NaoPross/z80uPC/doc/report/res/logo_sam.pdf

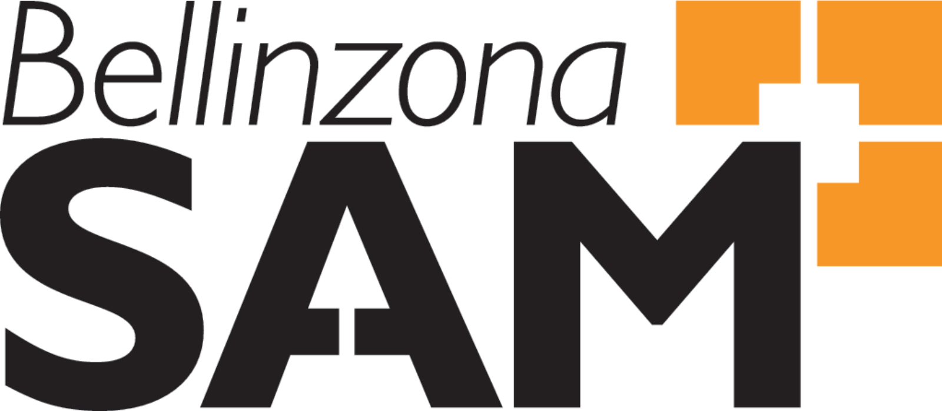
[picture p2: page 1]
