NaoPross/z80uPC/res/ATFBlast_ALL/ATFblast.TIF

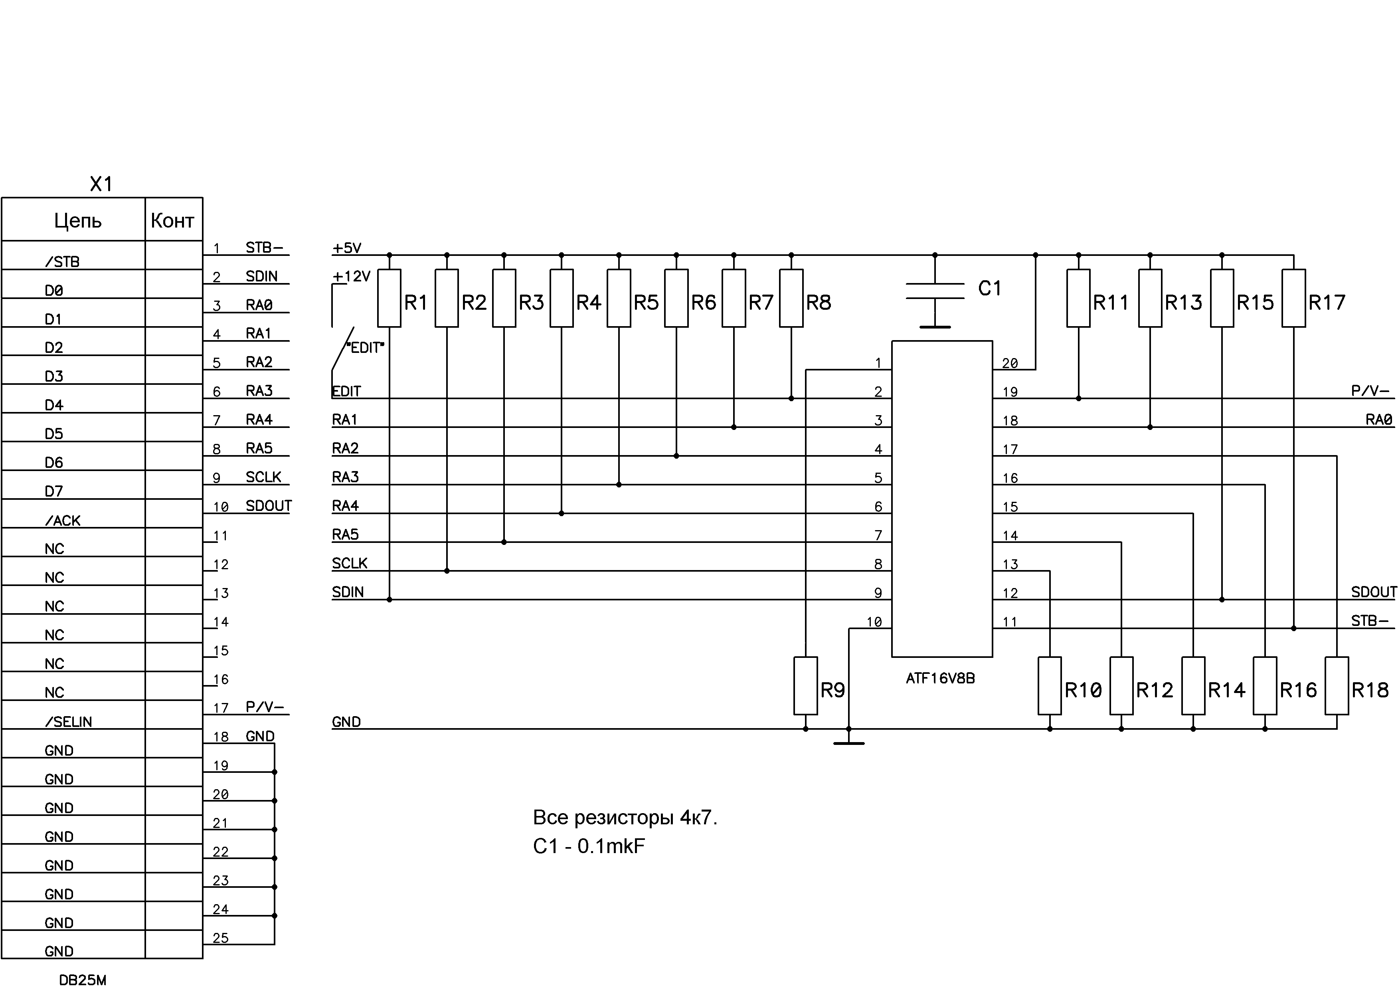
res/ATFBlast_ALL/ATFblast.TIF
