NaoPross/z80uPC/res/ATFBlast_ALL/direct.gif

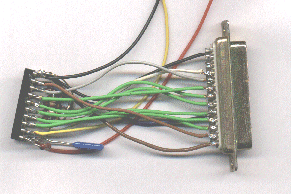
res/ATFBlast_ALL/direct.gif
