NaoPross/z80uPC/doc/BOM.ods

Z80 MicroComputer BOM
Tipo | Componente | Specifica | Package | Prezzo | PCS | Fornitore | Link
Processore | Z8400AB1 | Z80ACPU | PLCC-68 |  | 1 | SAM
Porta I/O | Z8420AB1 | Z80APIO | PDIP-40 |  | 1 | SAM
Timer | Z8430AB1 | Z80ACTC | PDIP-28
RAM | HM62256BPL-7 | 8K x 8bit | PDIP-28 |  | 2 | SAM
EEPROM | AT28C64B-15PU | 8K x 8bit | PDIP-28 |  | 2 | SAM
UART RS232 | TL16C550CFN |  | PLCC-44 | SFr. 4.35 | 1 | Distrelec | http://www.distrelec.ch/en/interface-ic-uart-plcc-44-tl16c550-texas-instruments-tl16c550cfn/p/30011774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
total |  |  |  | SFr. 4.35
