NaoPross/z80uPC/hw/Project Outputs for z80uPC/z80uPC.pdf

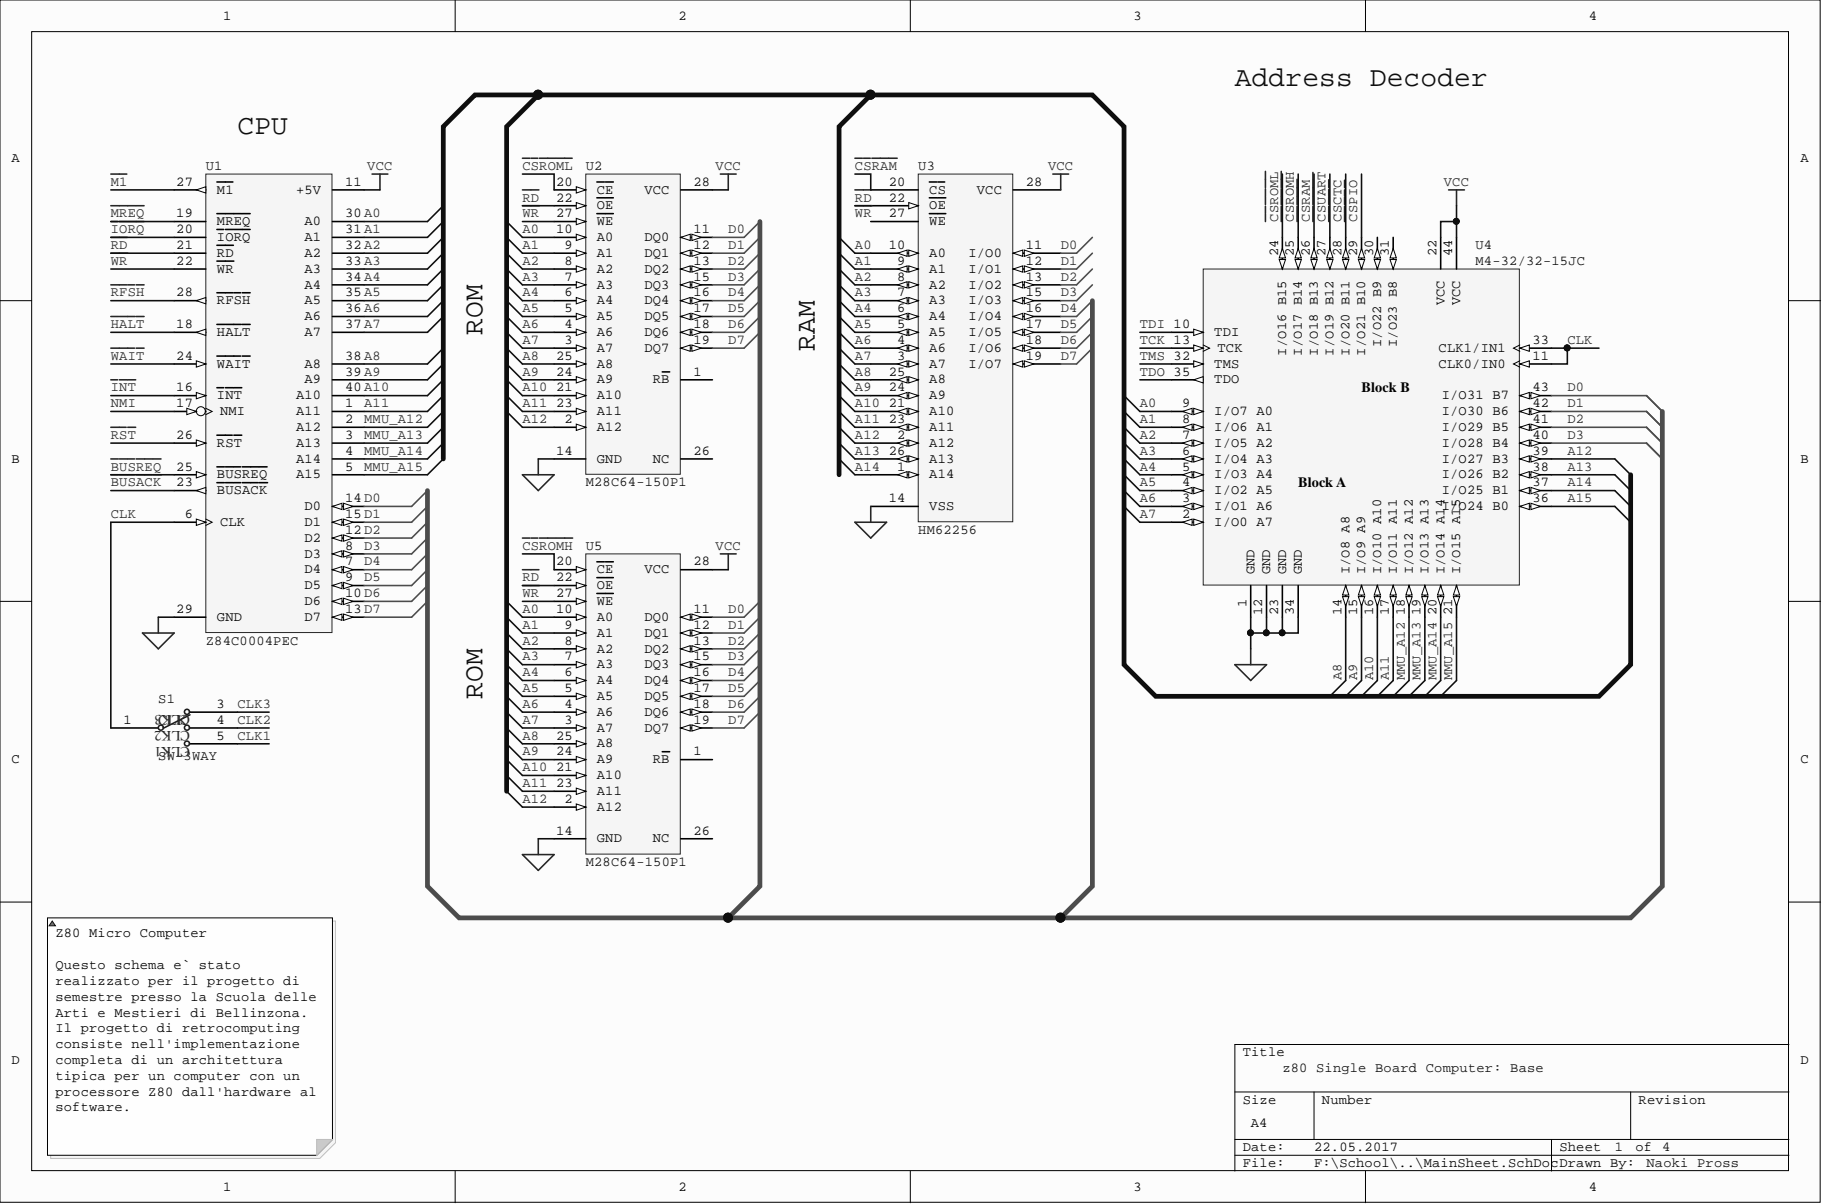
[picture p7: page 1]

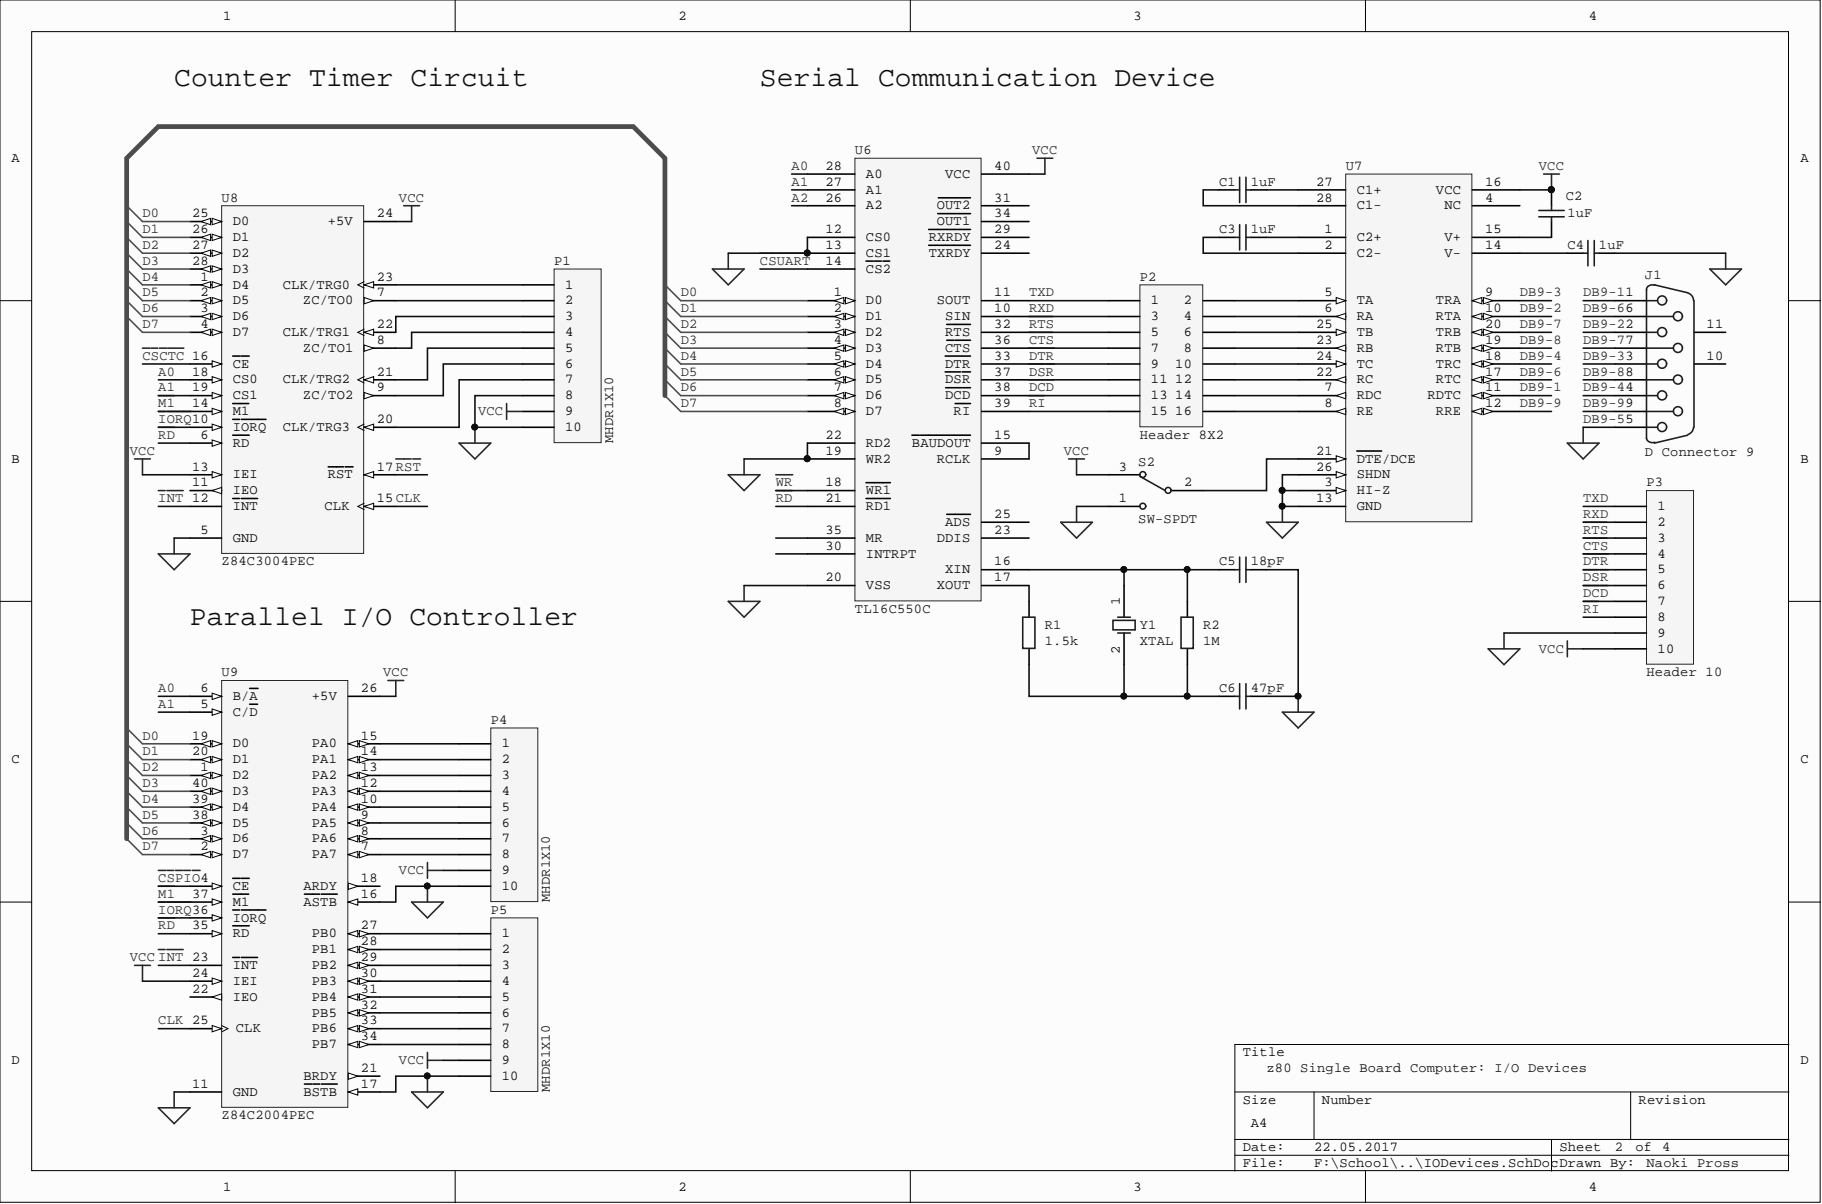
[picture p8: page 2]

1 0 R X D | 6 | 1 0 D B 9 -
3 2 R T S | 2 5 | 2 0 D B 9 -

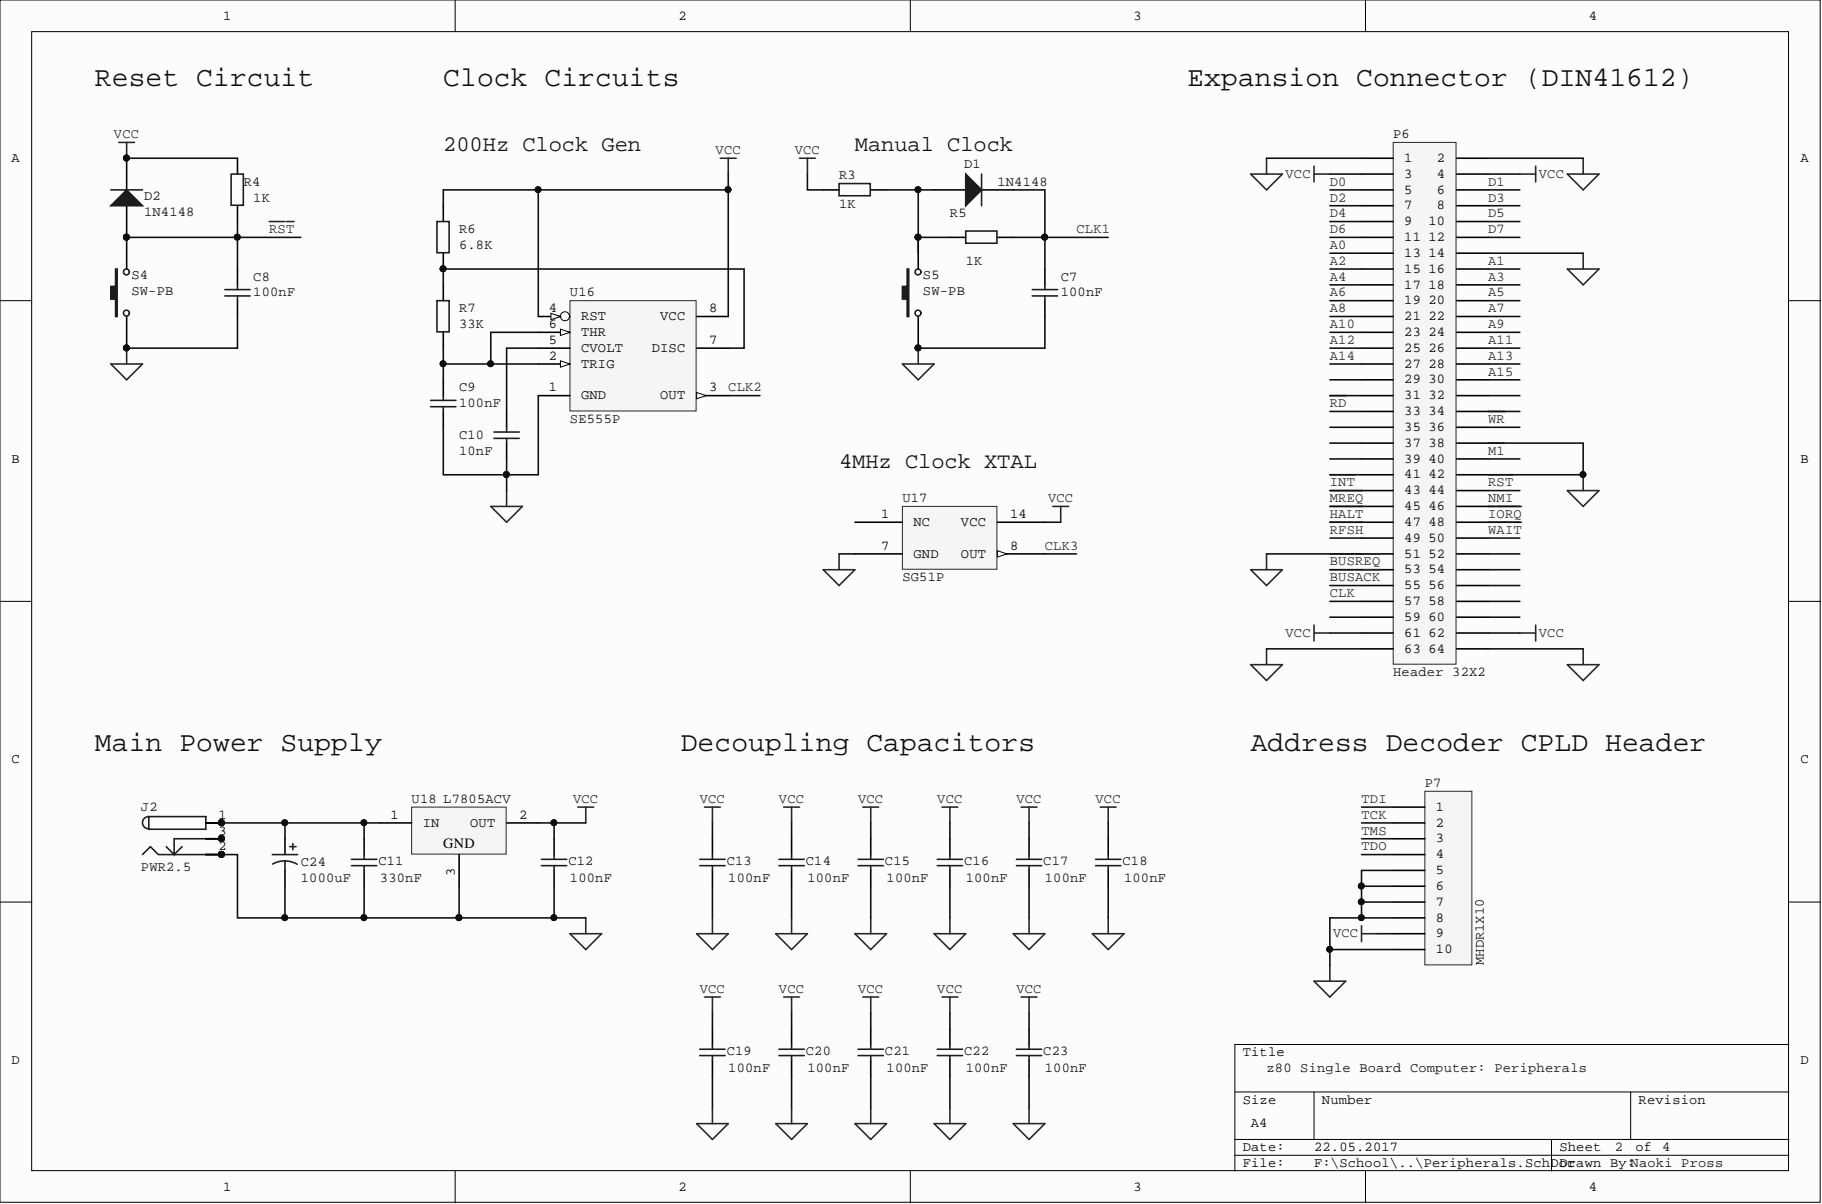
[picture p9: page 3]

TRIG 2

GND 1

Address Decoder CPLD Header

Title
z80 Single Board Computer: Peripherals

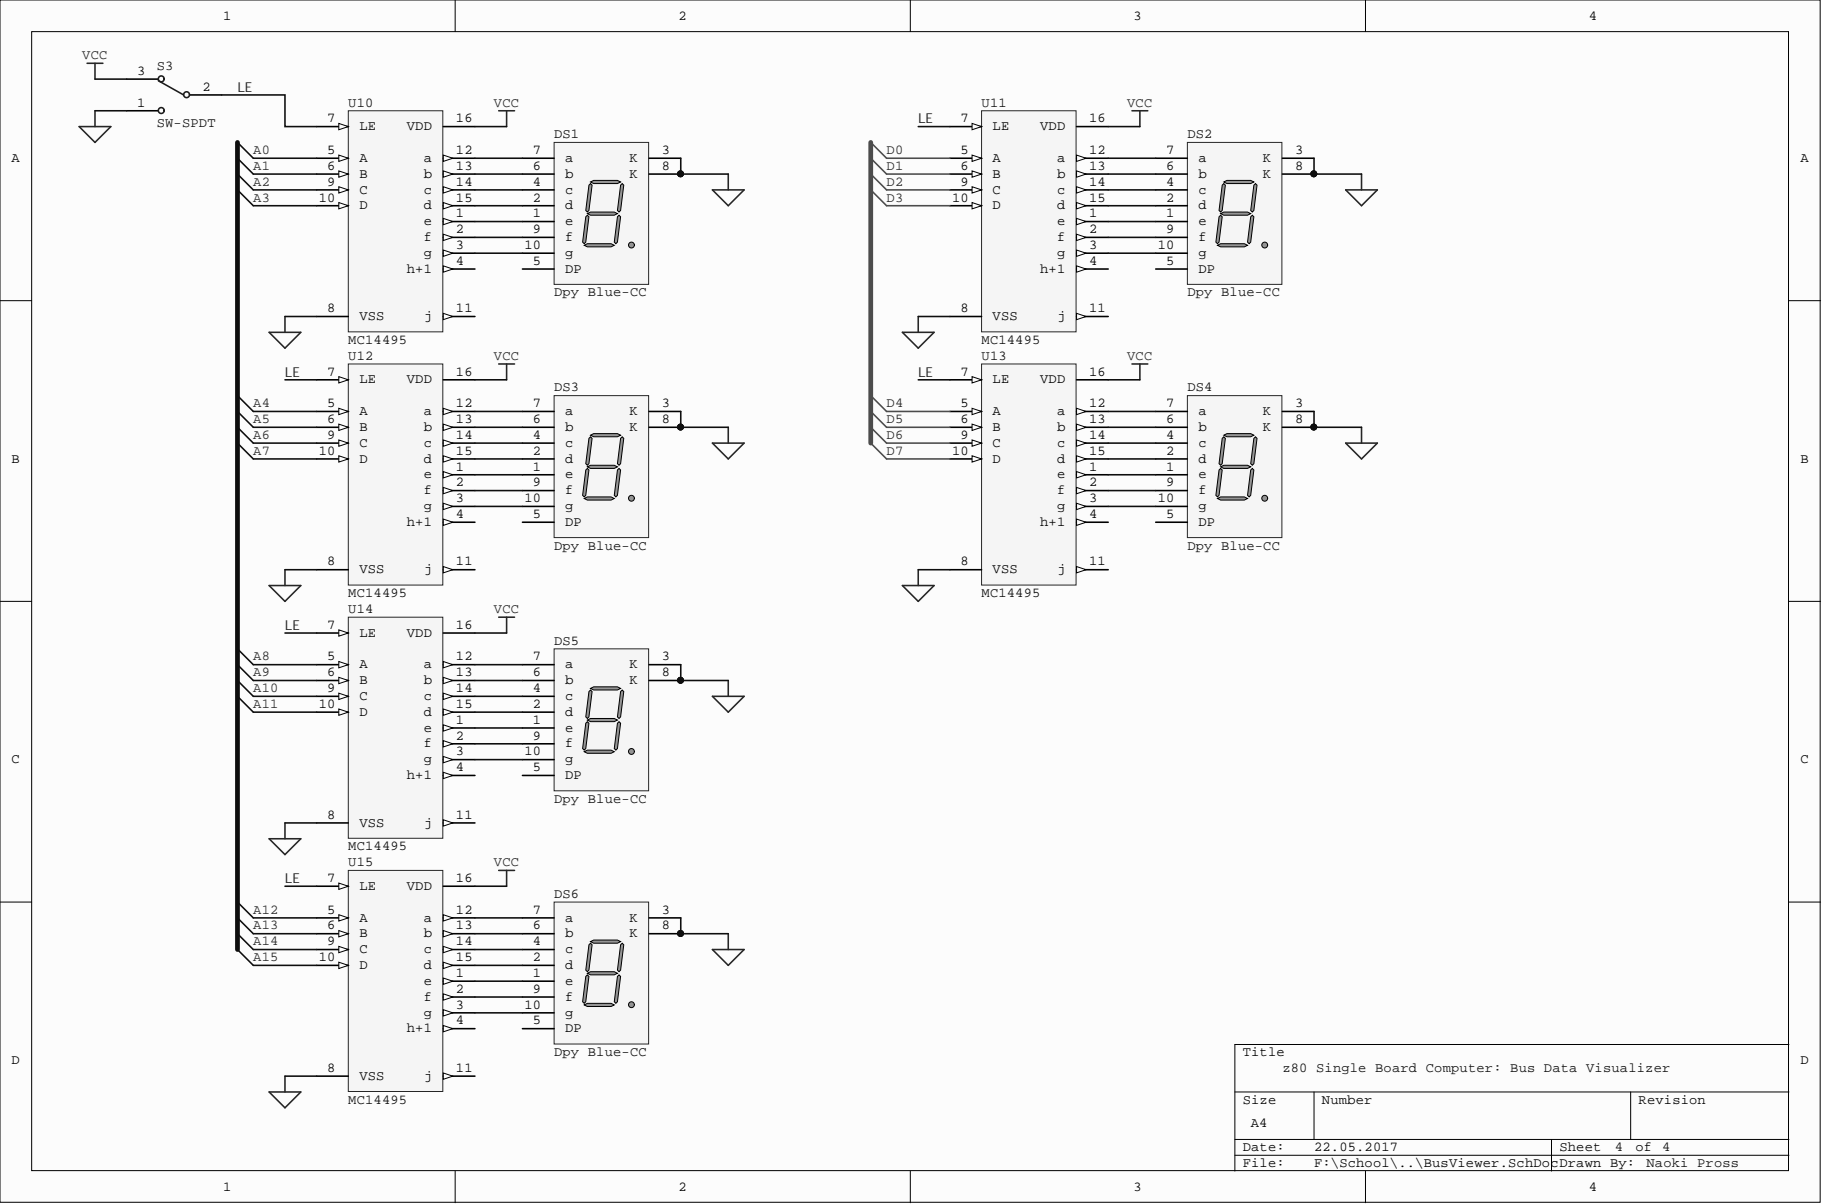
[picture p10: page 4]

z80 Single Board Computer: Bus Data Visualizer
