NaoPross/z80uPC/doc/report/res/block_diagram.pdf

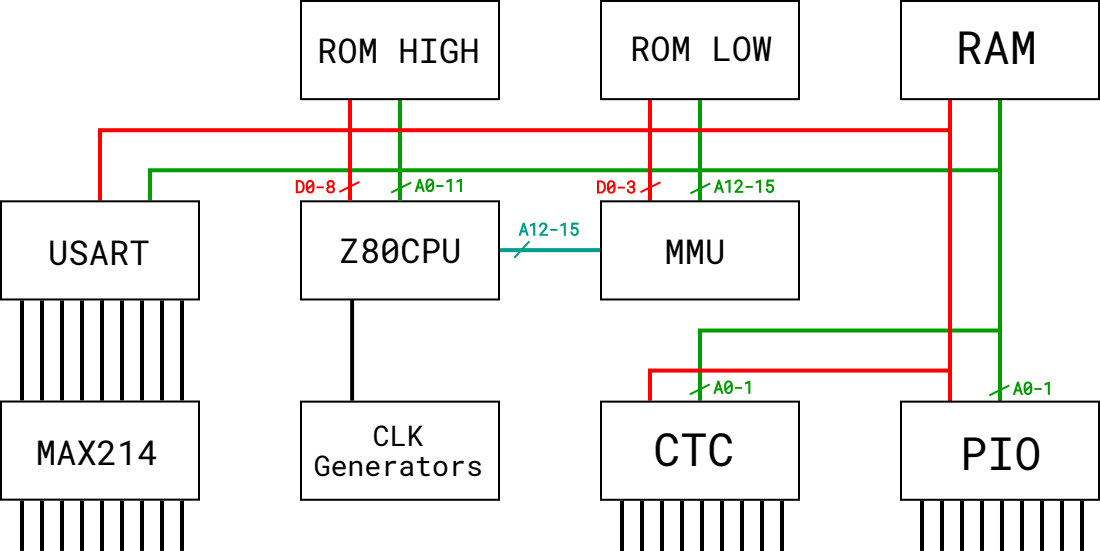
[picture p11: page 1]
Z80CPU; ROM HIGH; ROM LOW; RAM; MMU; CLK; Generators; CTC; PIO; USART; MAX214
