NaoPross/z80uPC/hw/Project Outputs for z80uPC/z80uPC_PCB.pdf

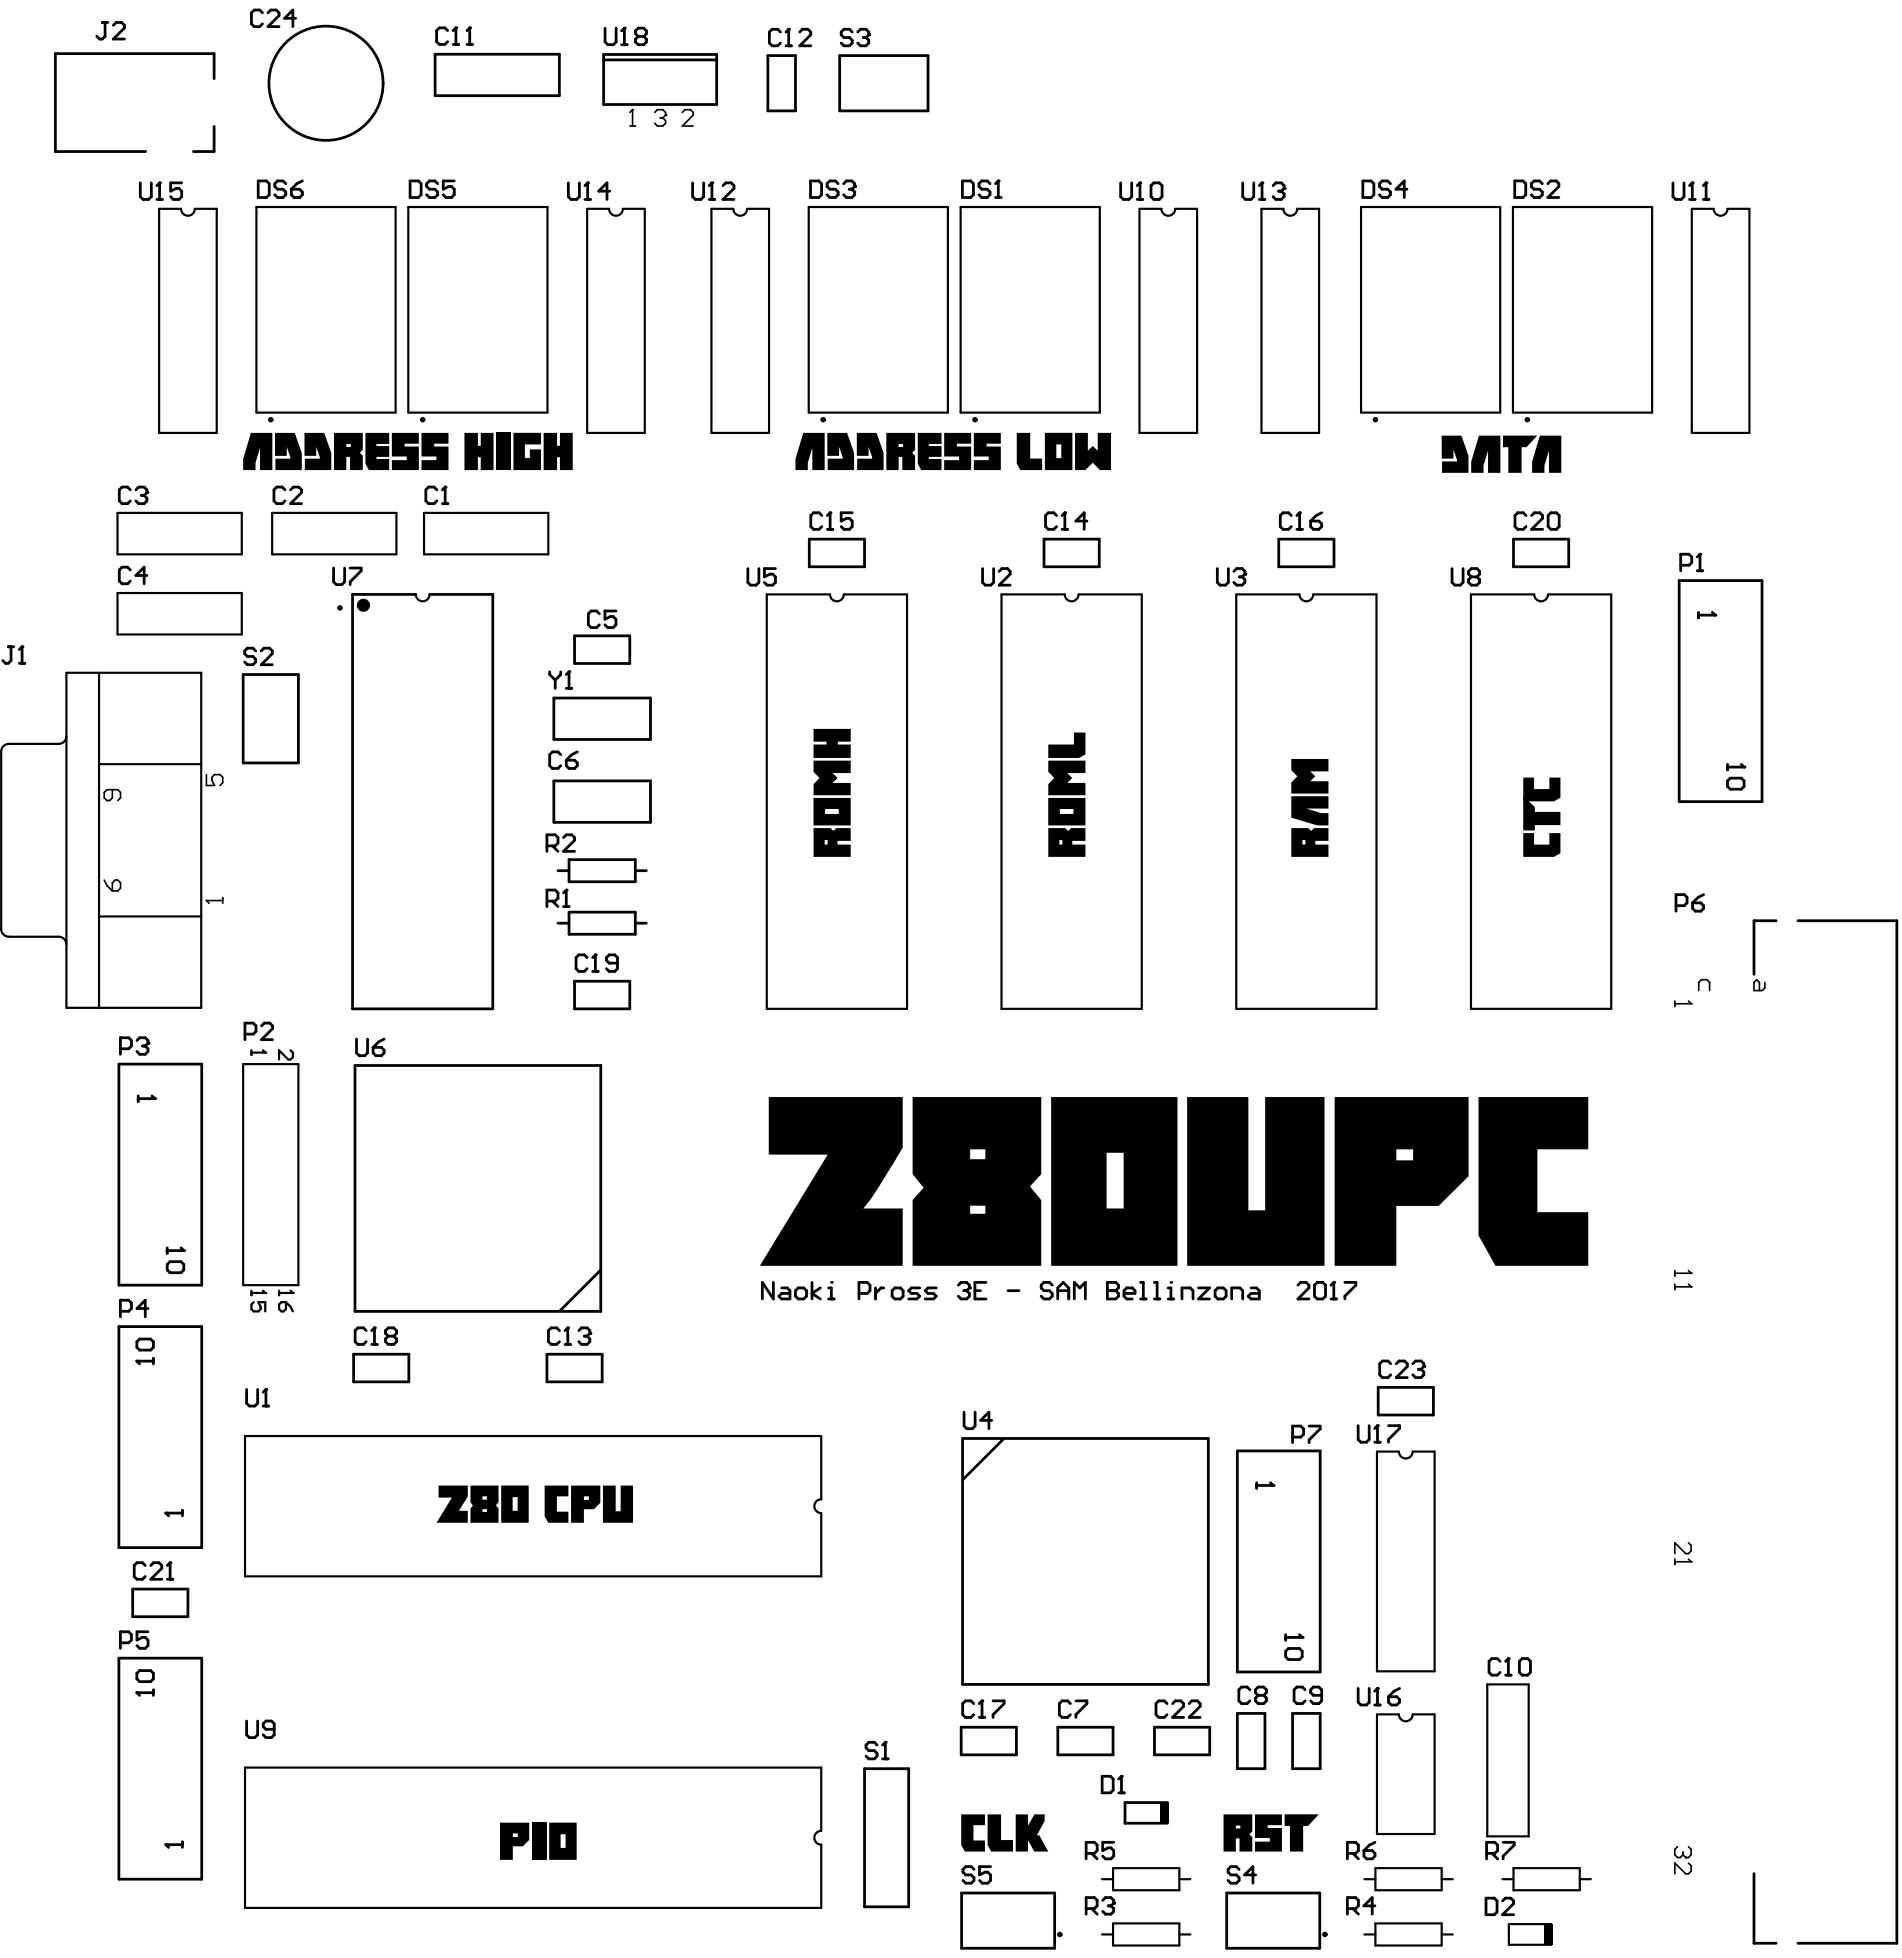
[picture p12: page 1]

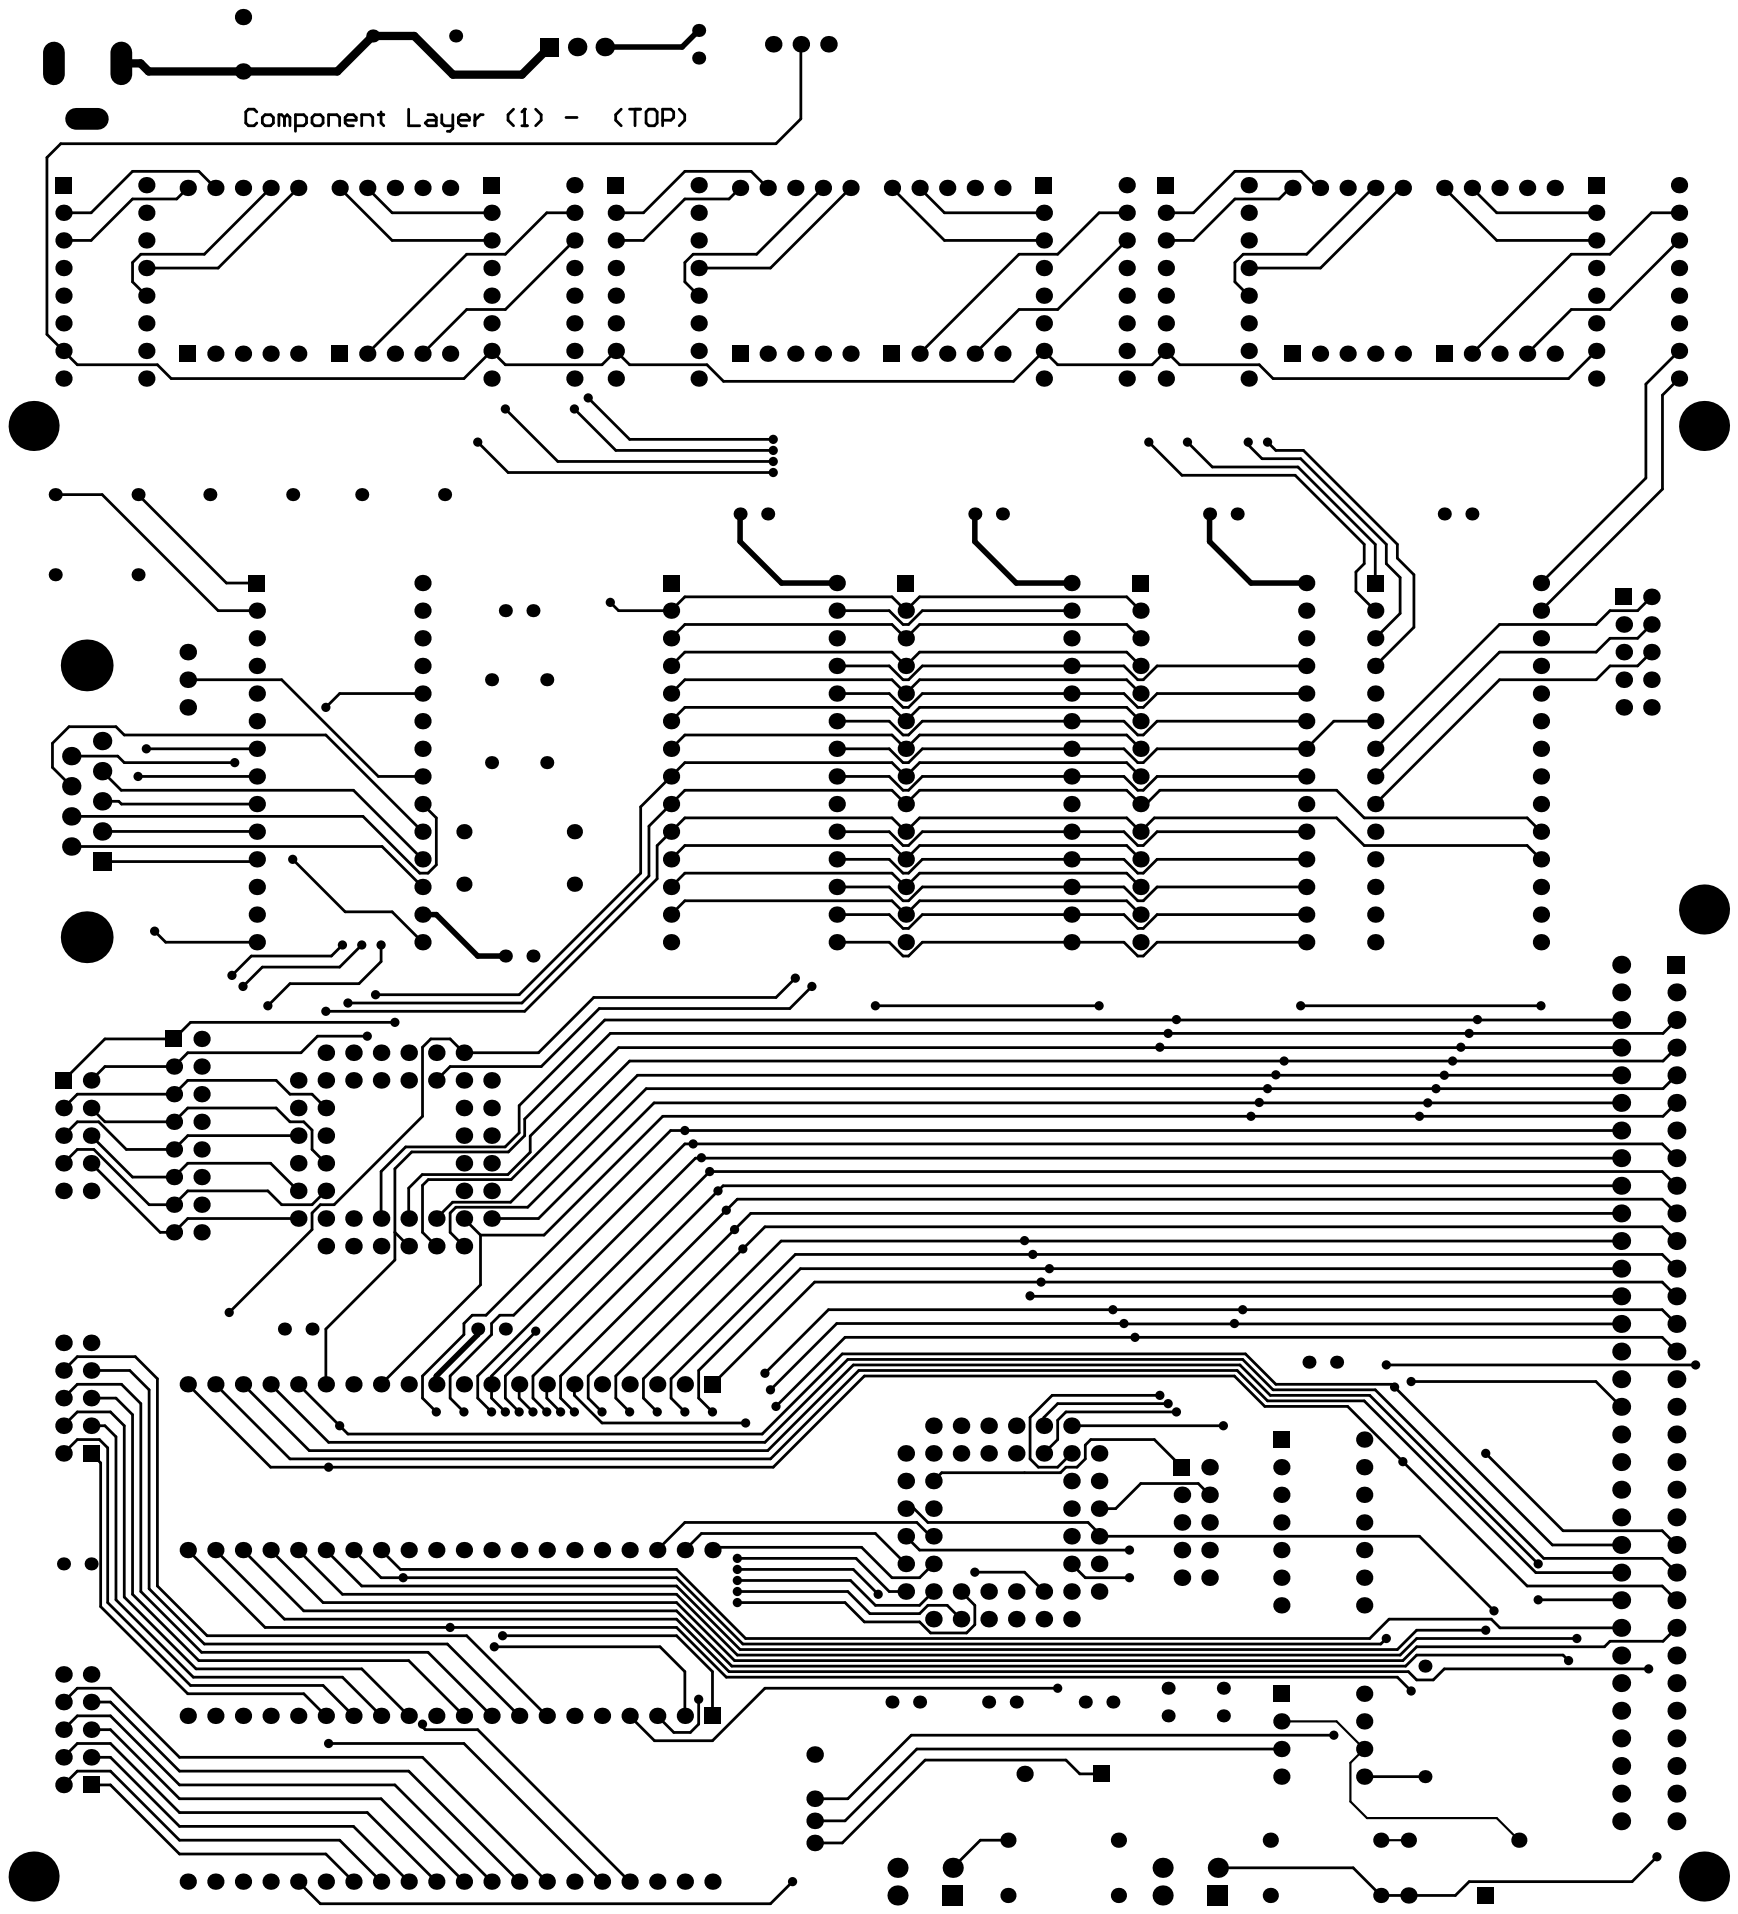
[picture p13: page 2]

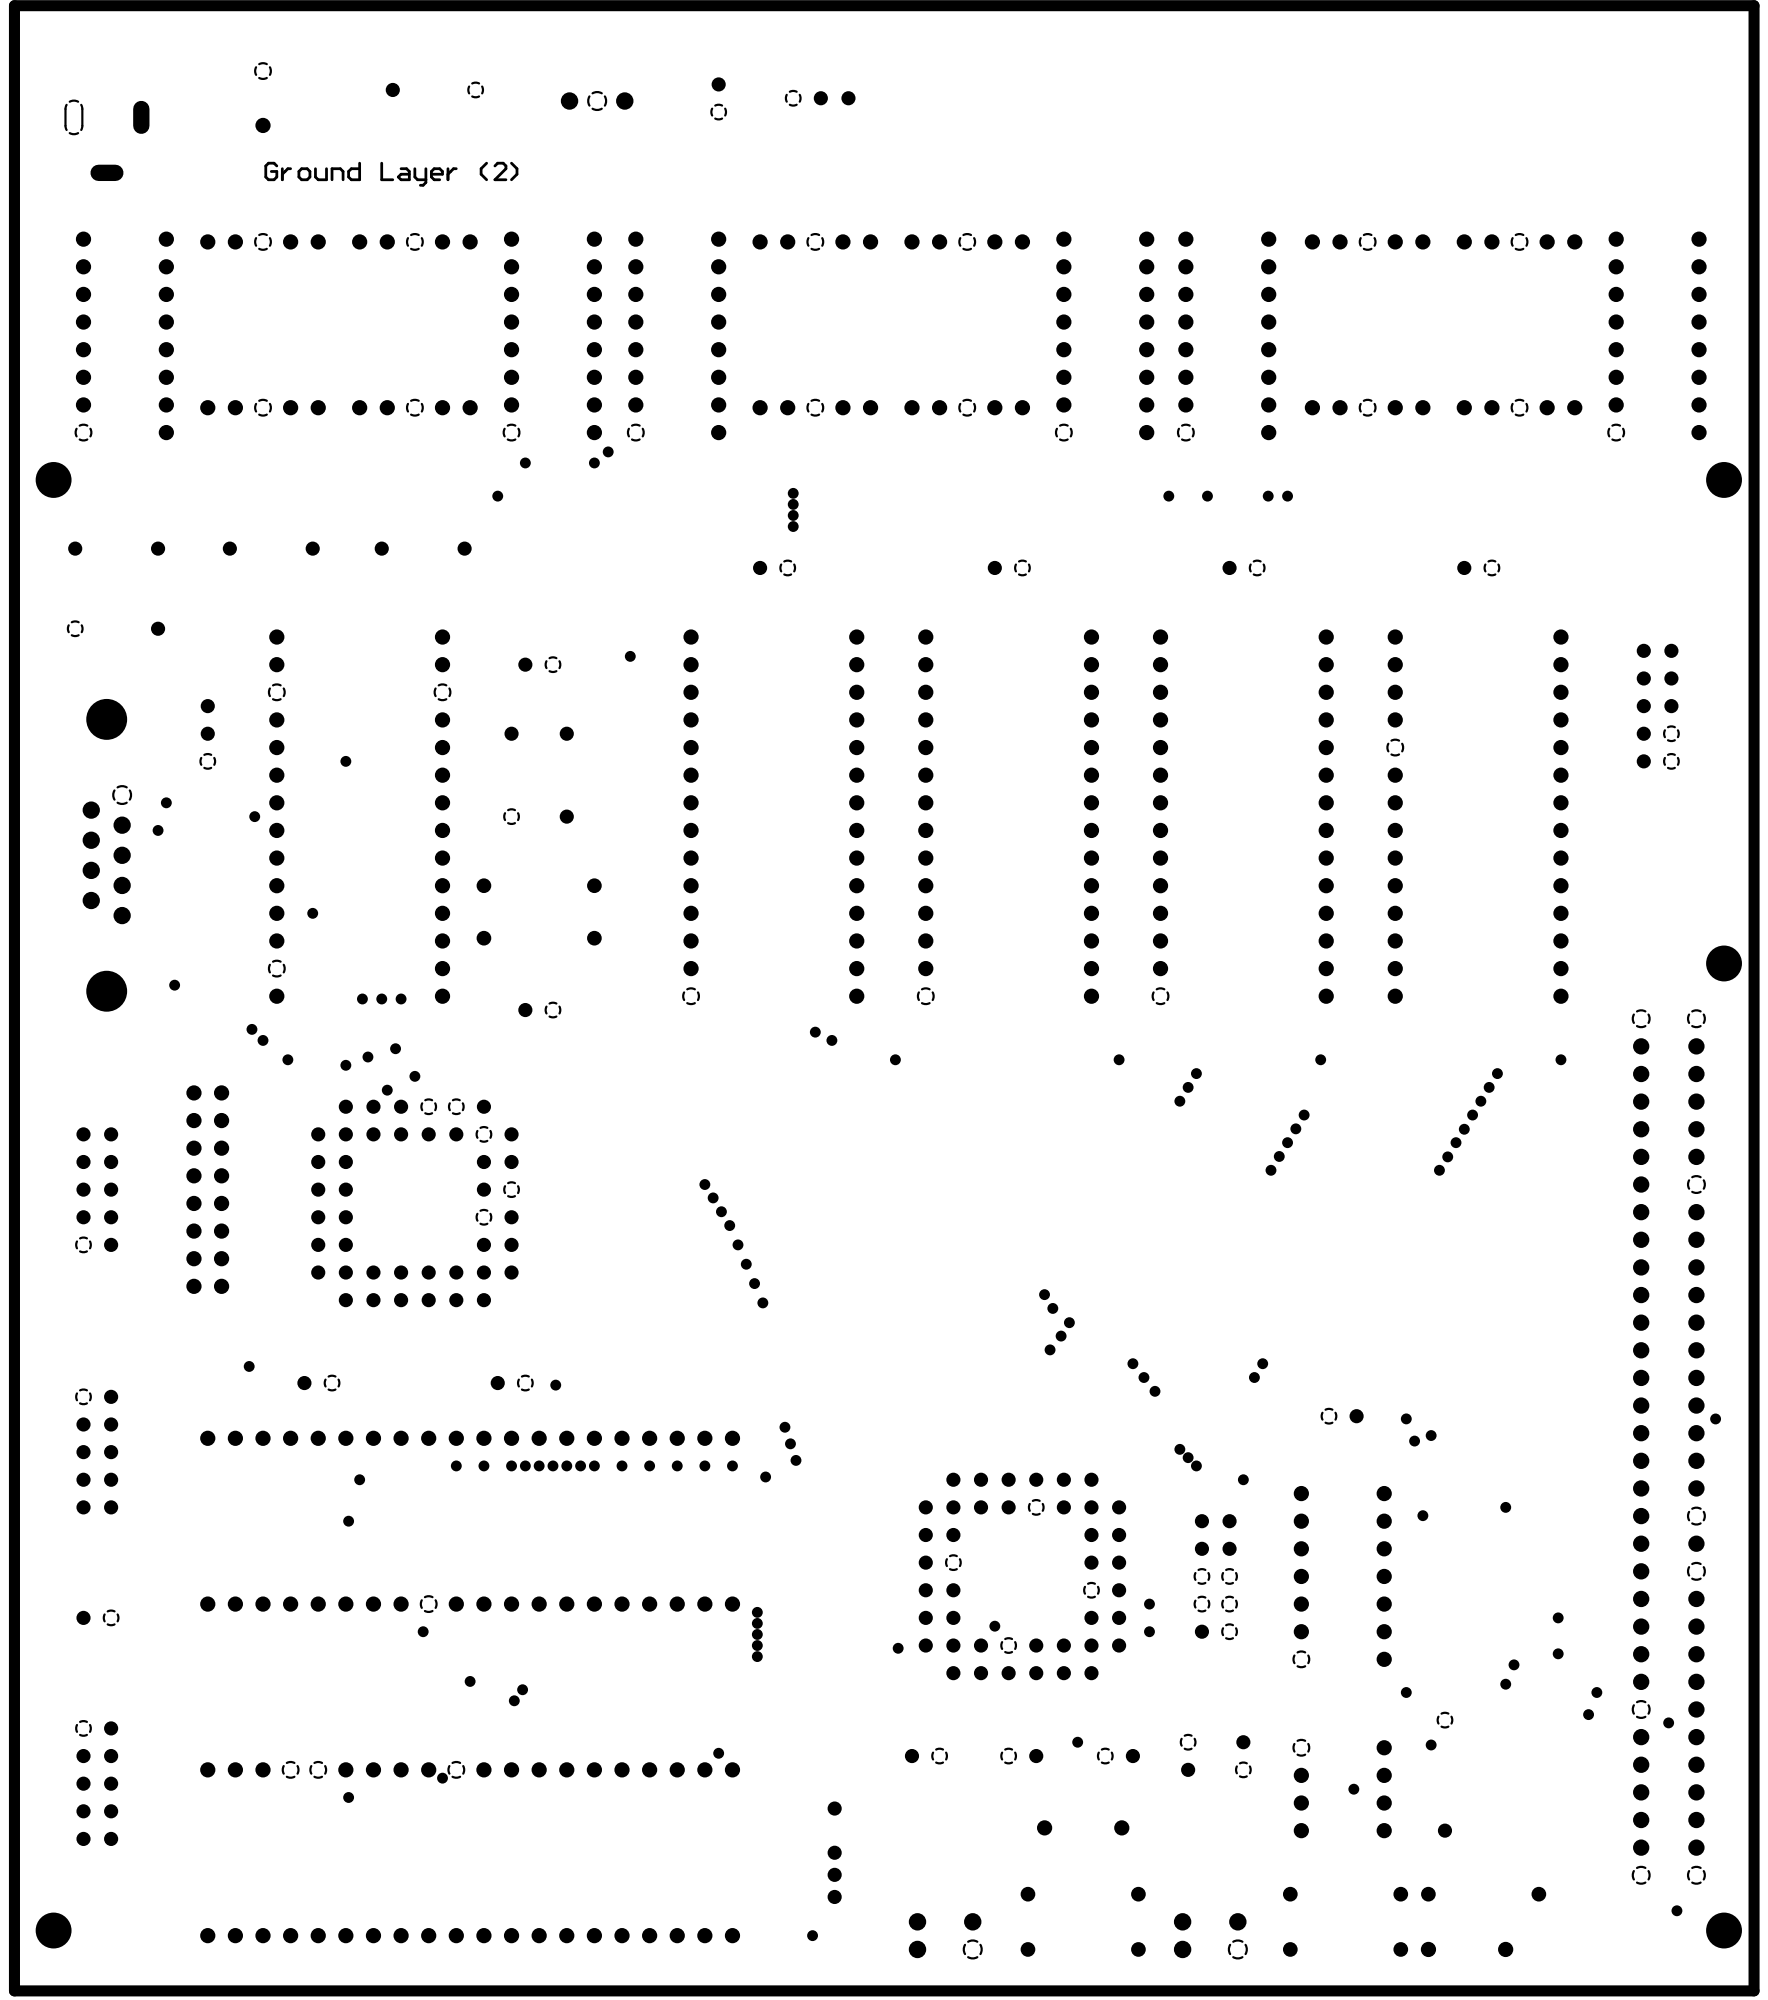
[picture p14: page 3]

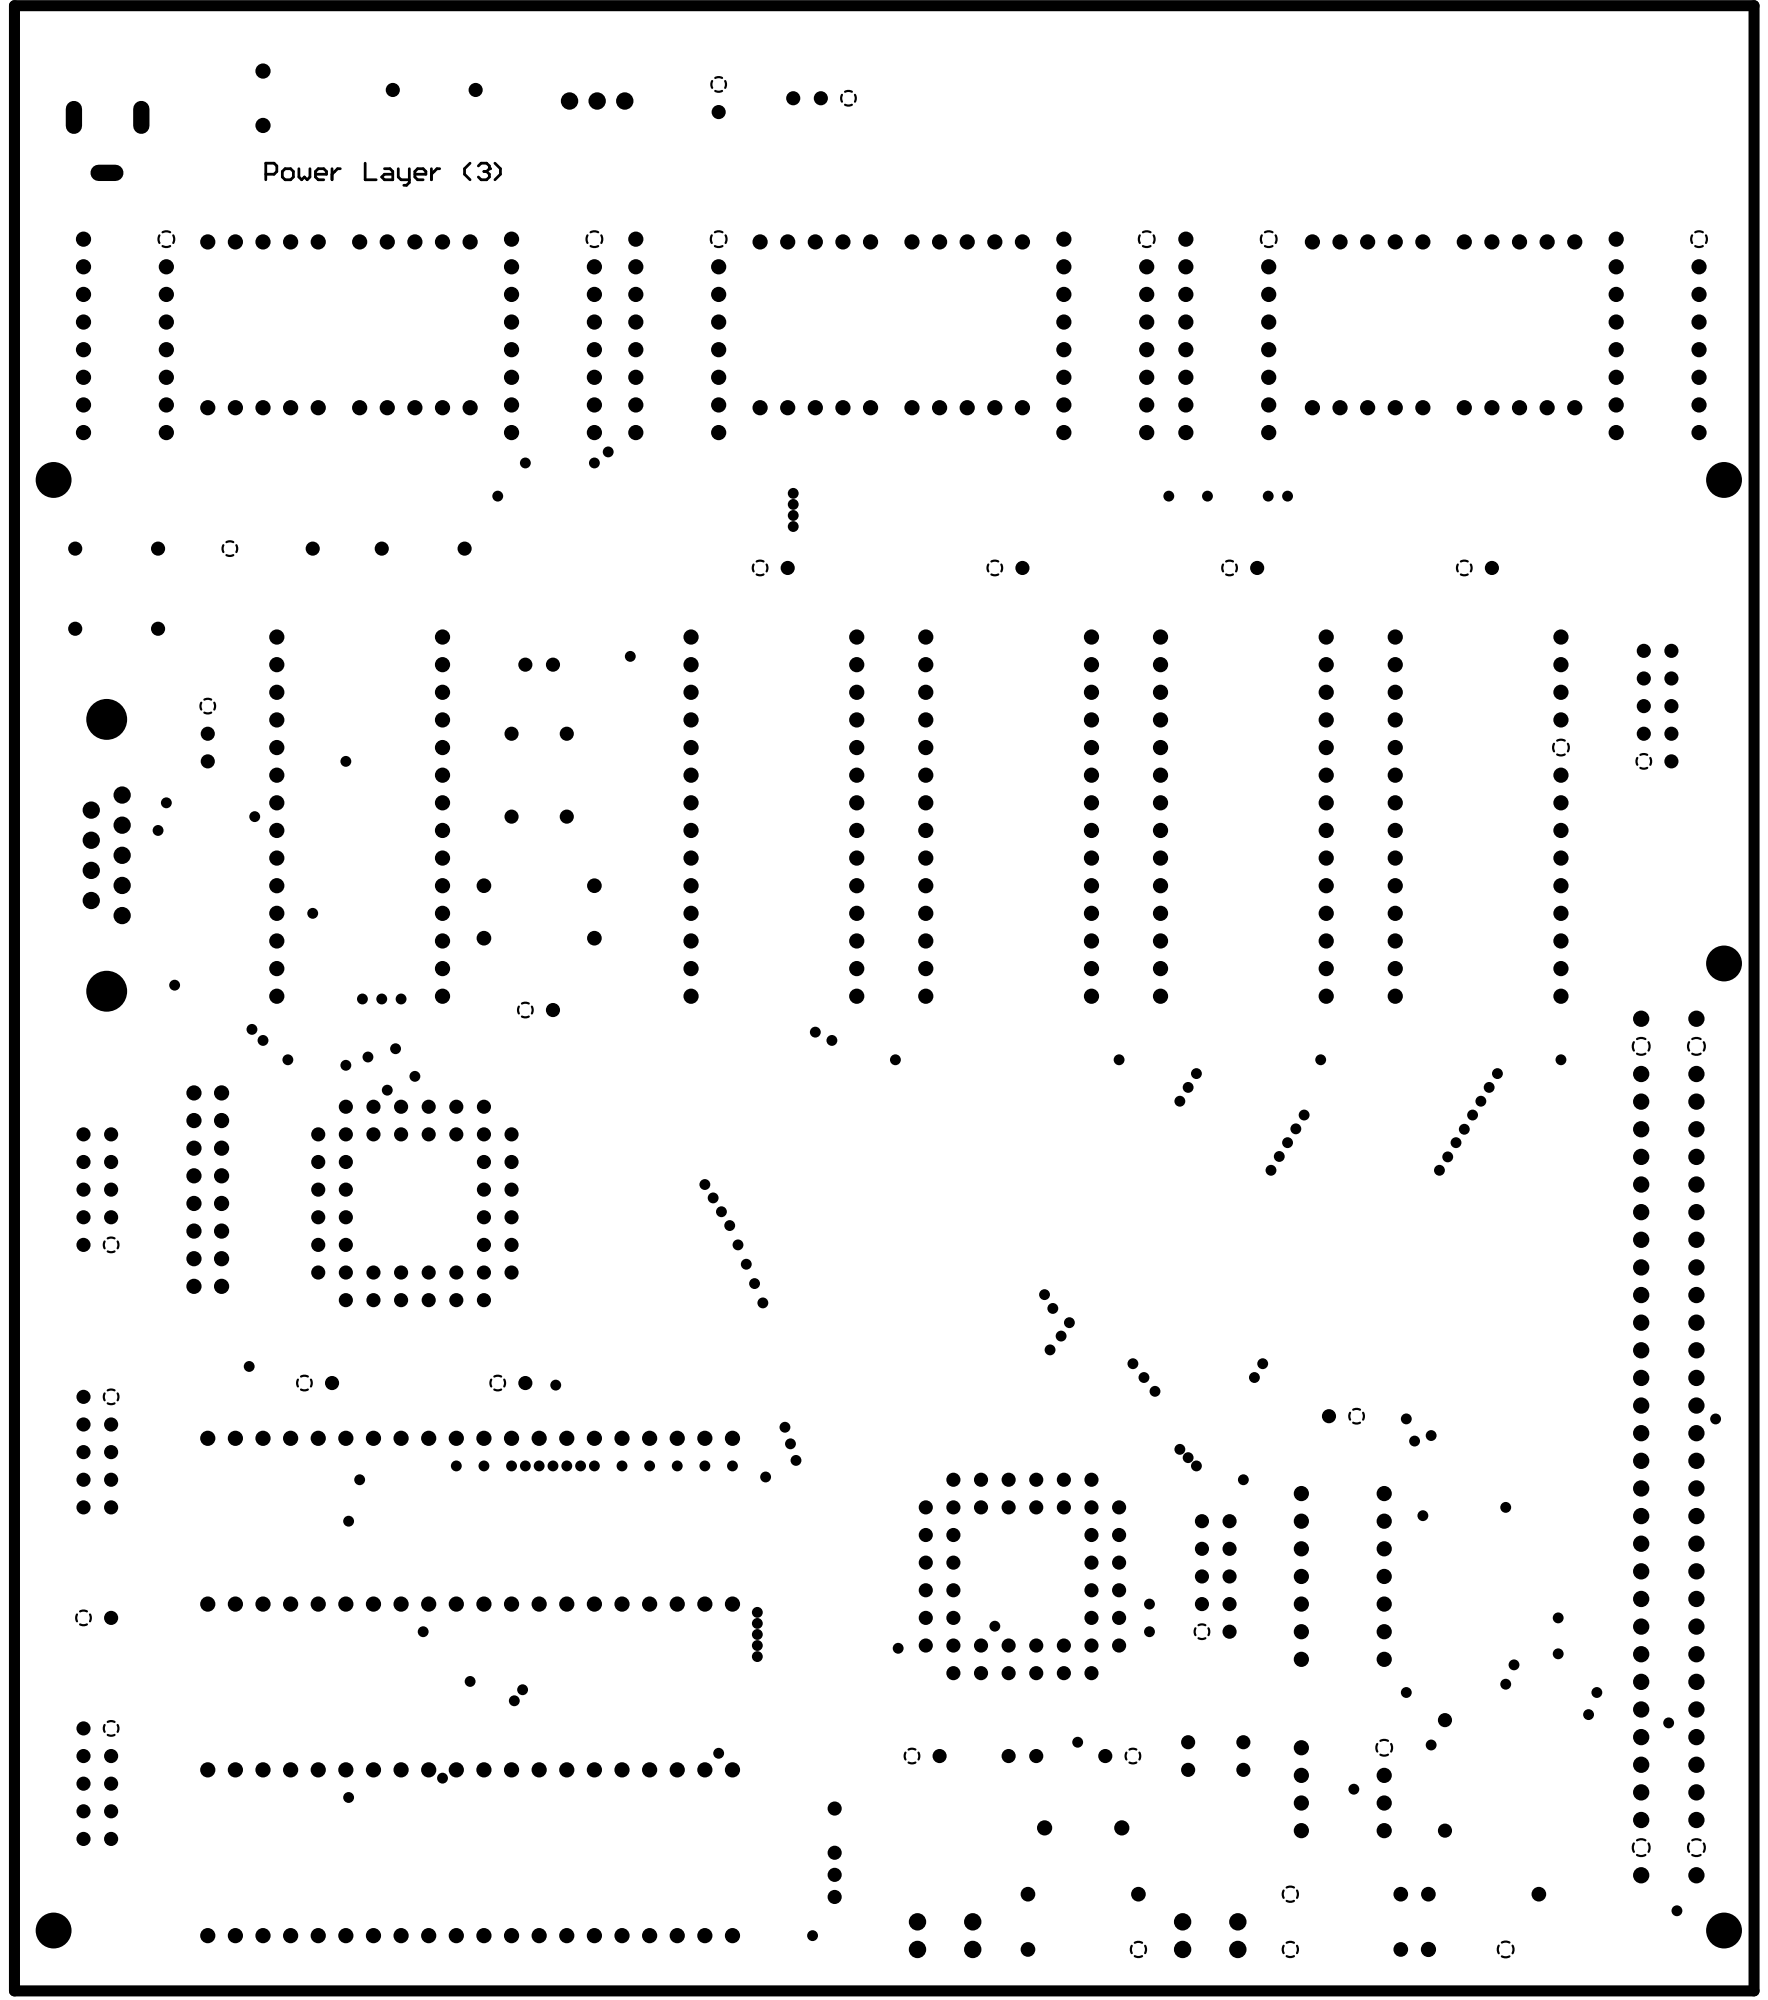
[picture p15: page 4]

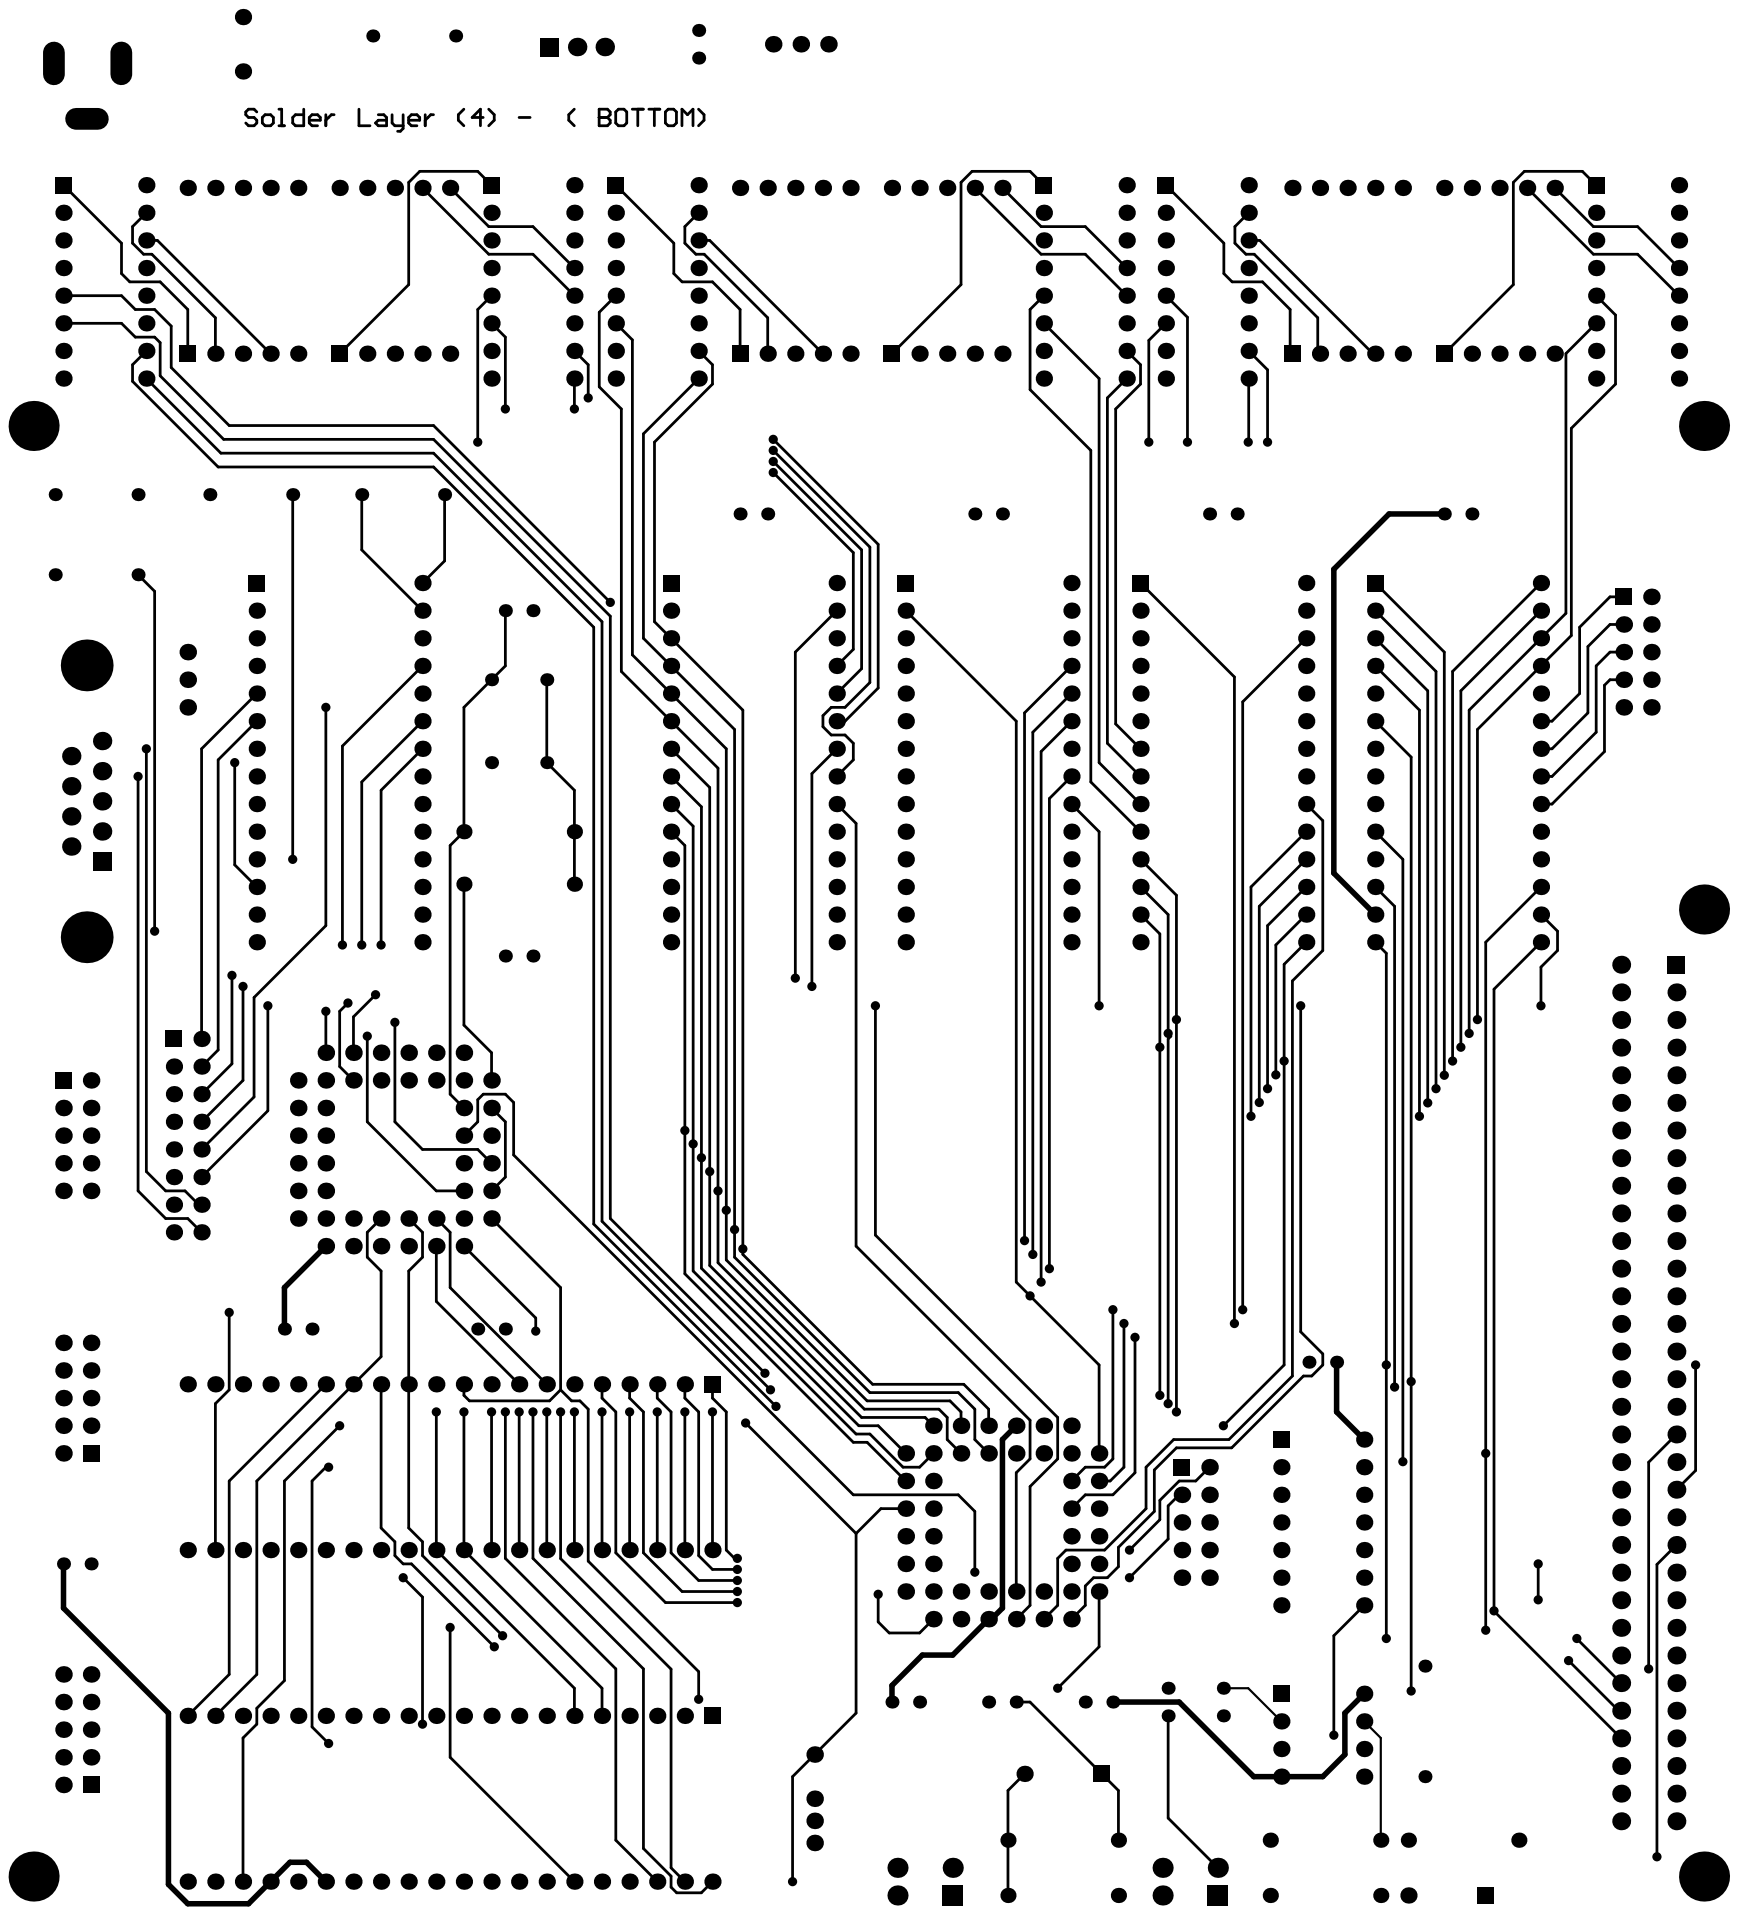
[picture p16: page 5]
