NaoPross/z80uPC/res/ATFBlast_ALL/AtfBlast_board_bottom.pdf

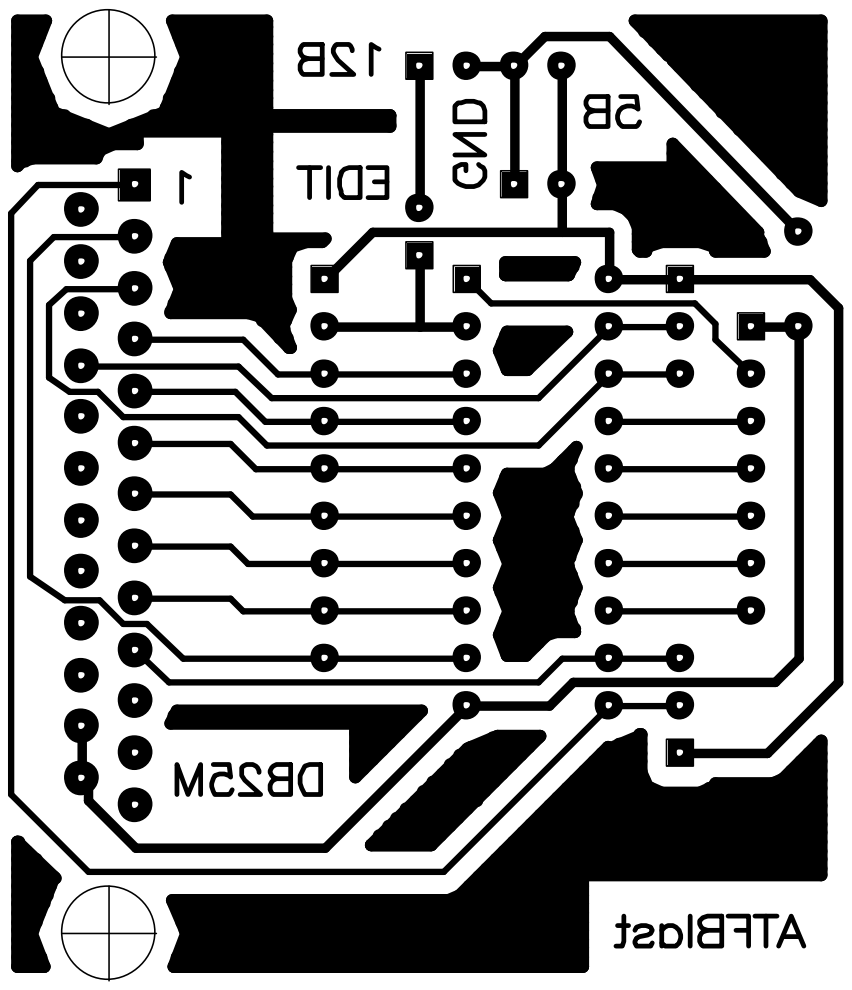
[picture p17: page 1]
