NaoPross/z80uPC/res/ATFBlast_ALL/AtfBlast_board_top.pdf

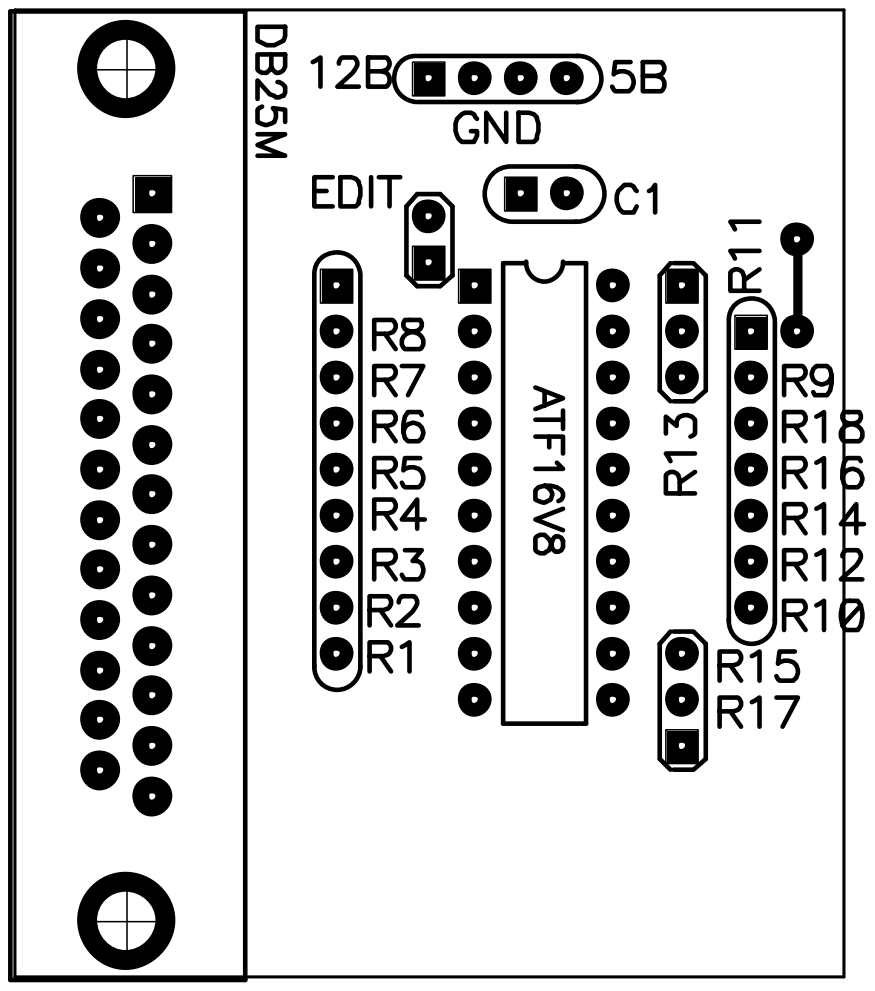
[picture p18: page 1]
