NaoPross/z80uPC/res/ATFBlast_ALL/AtfBlast_sch.pdf

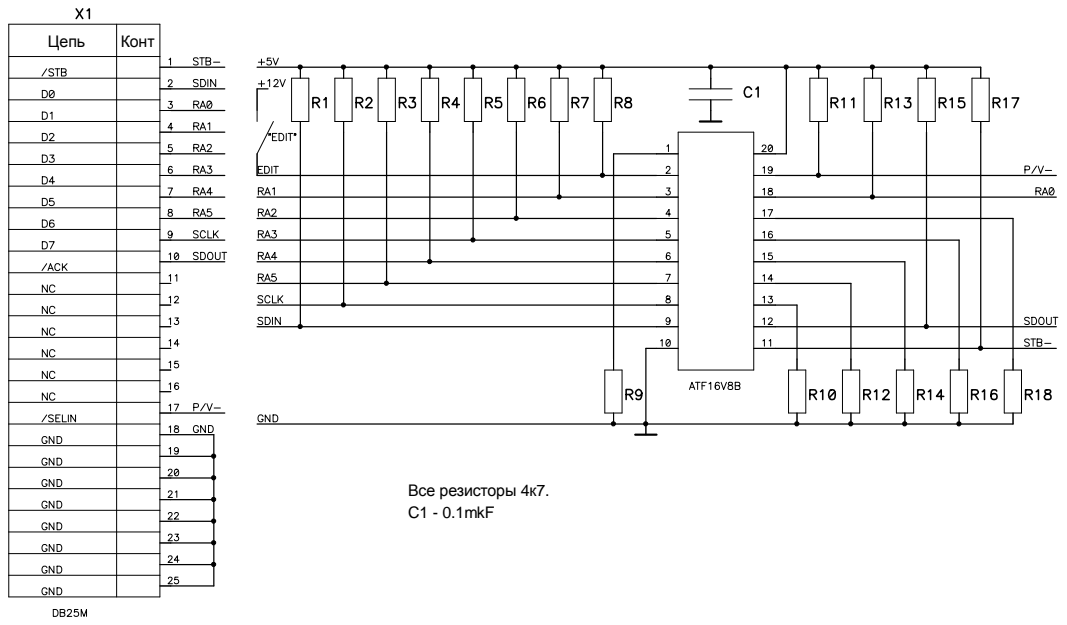
[picture p19: page 1]
C1 - 0.1mkF; Цепь; Конт; Все резисторы 4к7.
