NaoPross/z80uPC/(list of files, drawings)

Other design files:
hw/BusViewer.SchDoc
hw/HITACHI Memory Non-Volatile RAM.SchLib
hw/IODevices.SchDoc
hw/MainBoard.PcbDoc
hw/MainBoard.PcbLib
hw/MainSheet.SchDoc
hw/Peripherals.SchDoc
hw/Power.SchDoc
hw/Seiko Epson Oscillator.SchLib
hw/z80uPC.PcbLib
hw/z80uPC.PrjPCB
hw/z80uPC.SCHLIB
res/ATFBlast_ALL/ATFblast.pcb
