NaoPross/z80uPC/res/elm_gal_kicad/KiCad/Elm_GAL_Programmer.kicad_pcb

## KiCad design res/elm_gal_kicad/KiCad/Elm_GAL_Programmer.kicad_pcb (2017-03-17)

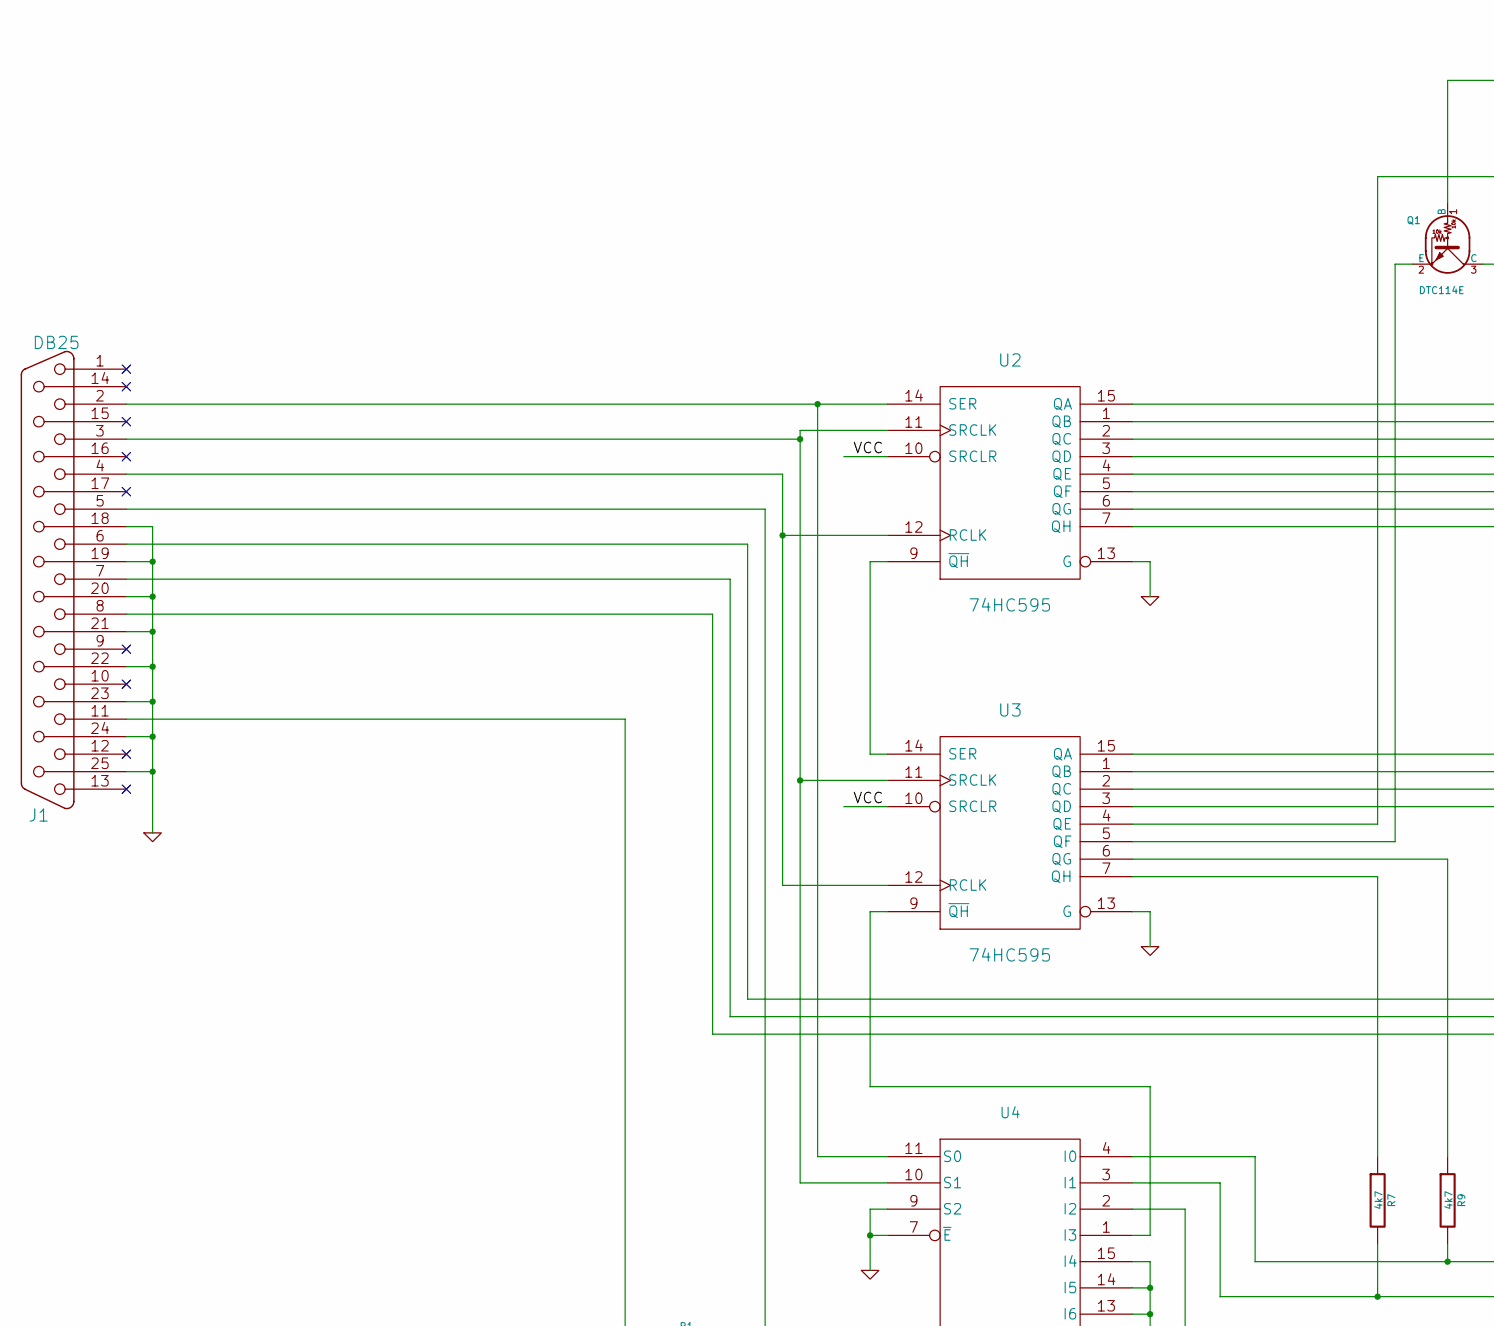
[picture p20: schematic Elm_GAL_Programmer.sch, part in row 1, column 1]

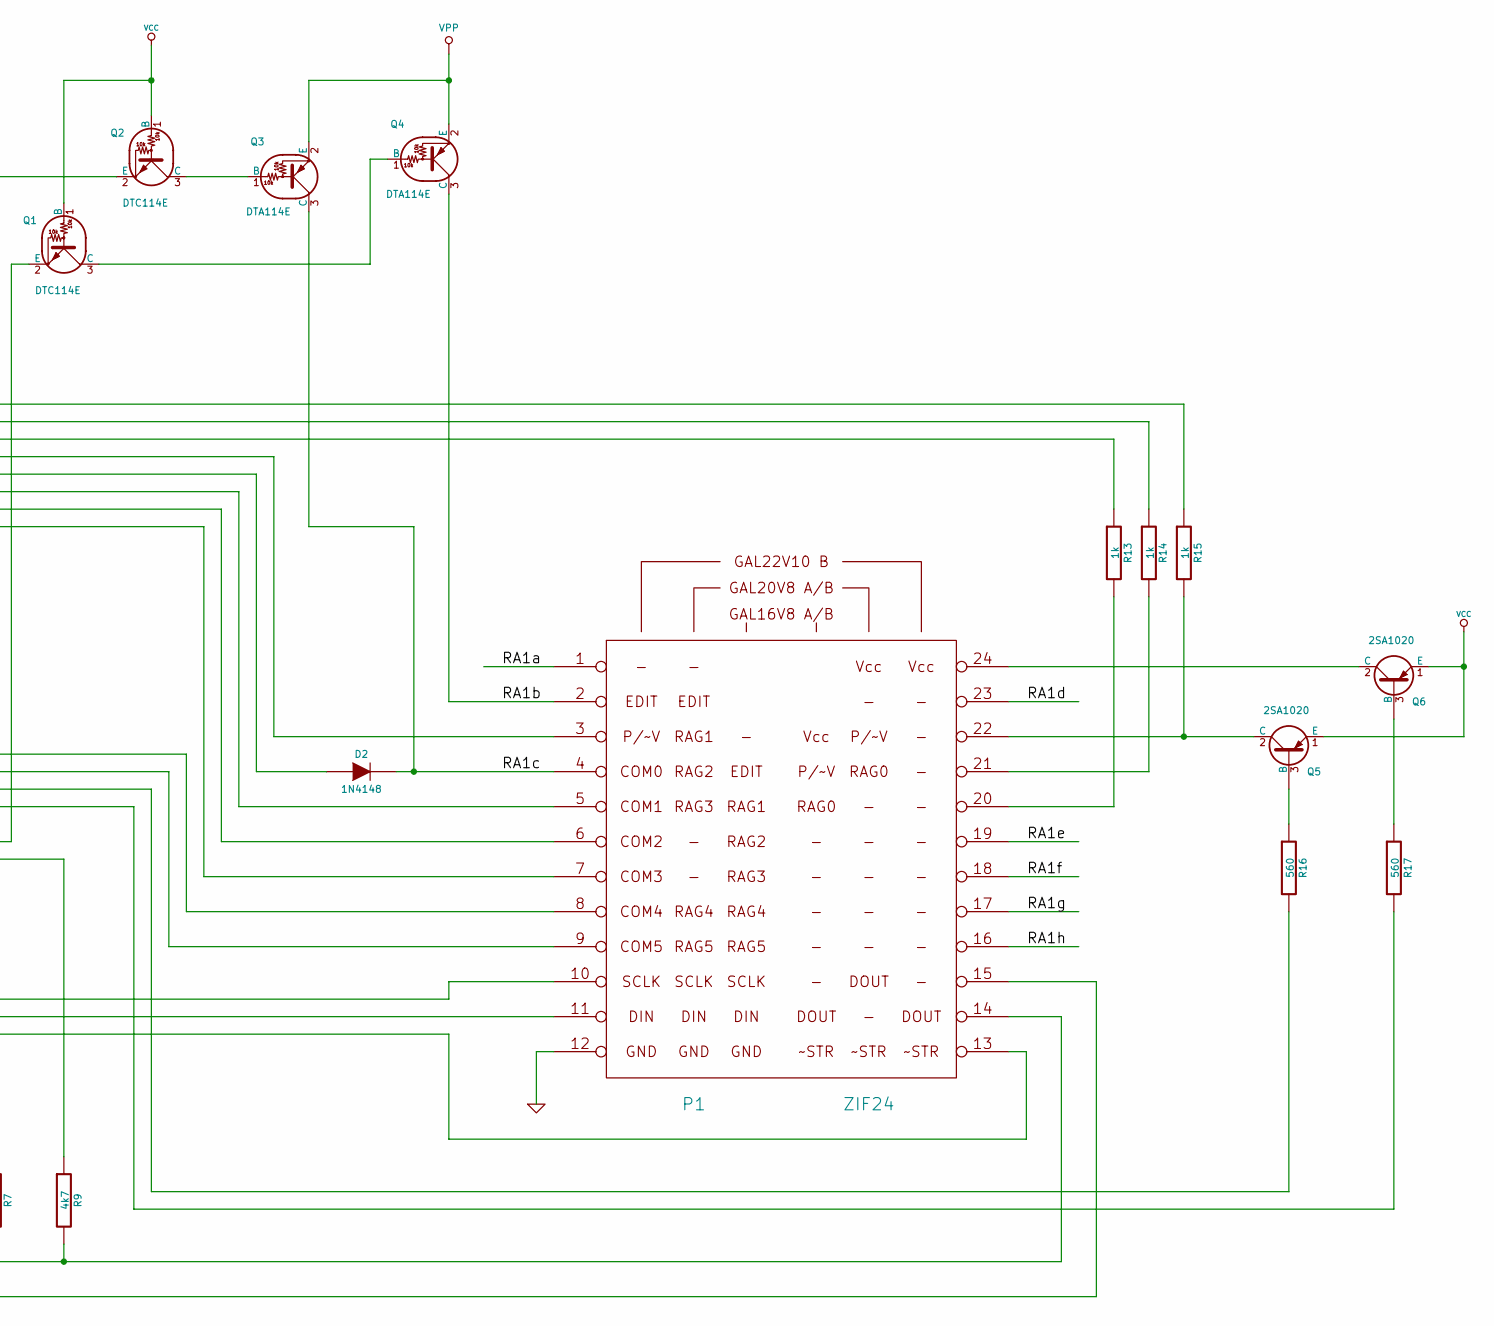
[picture p21: schematic Elm_GAL_Programmer.sch, part in row 1, column 2]

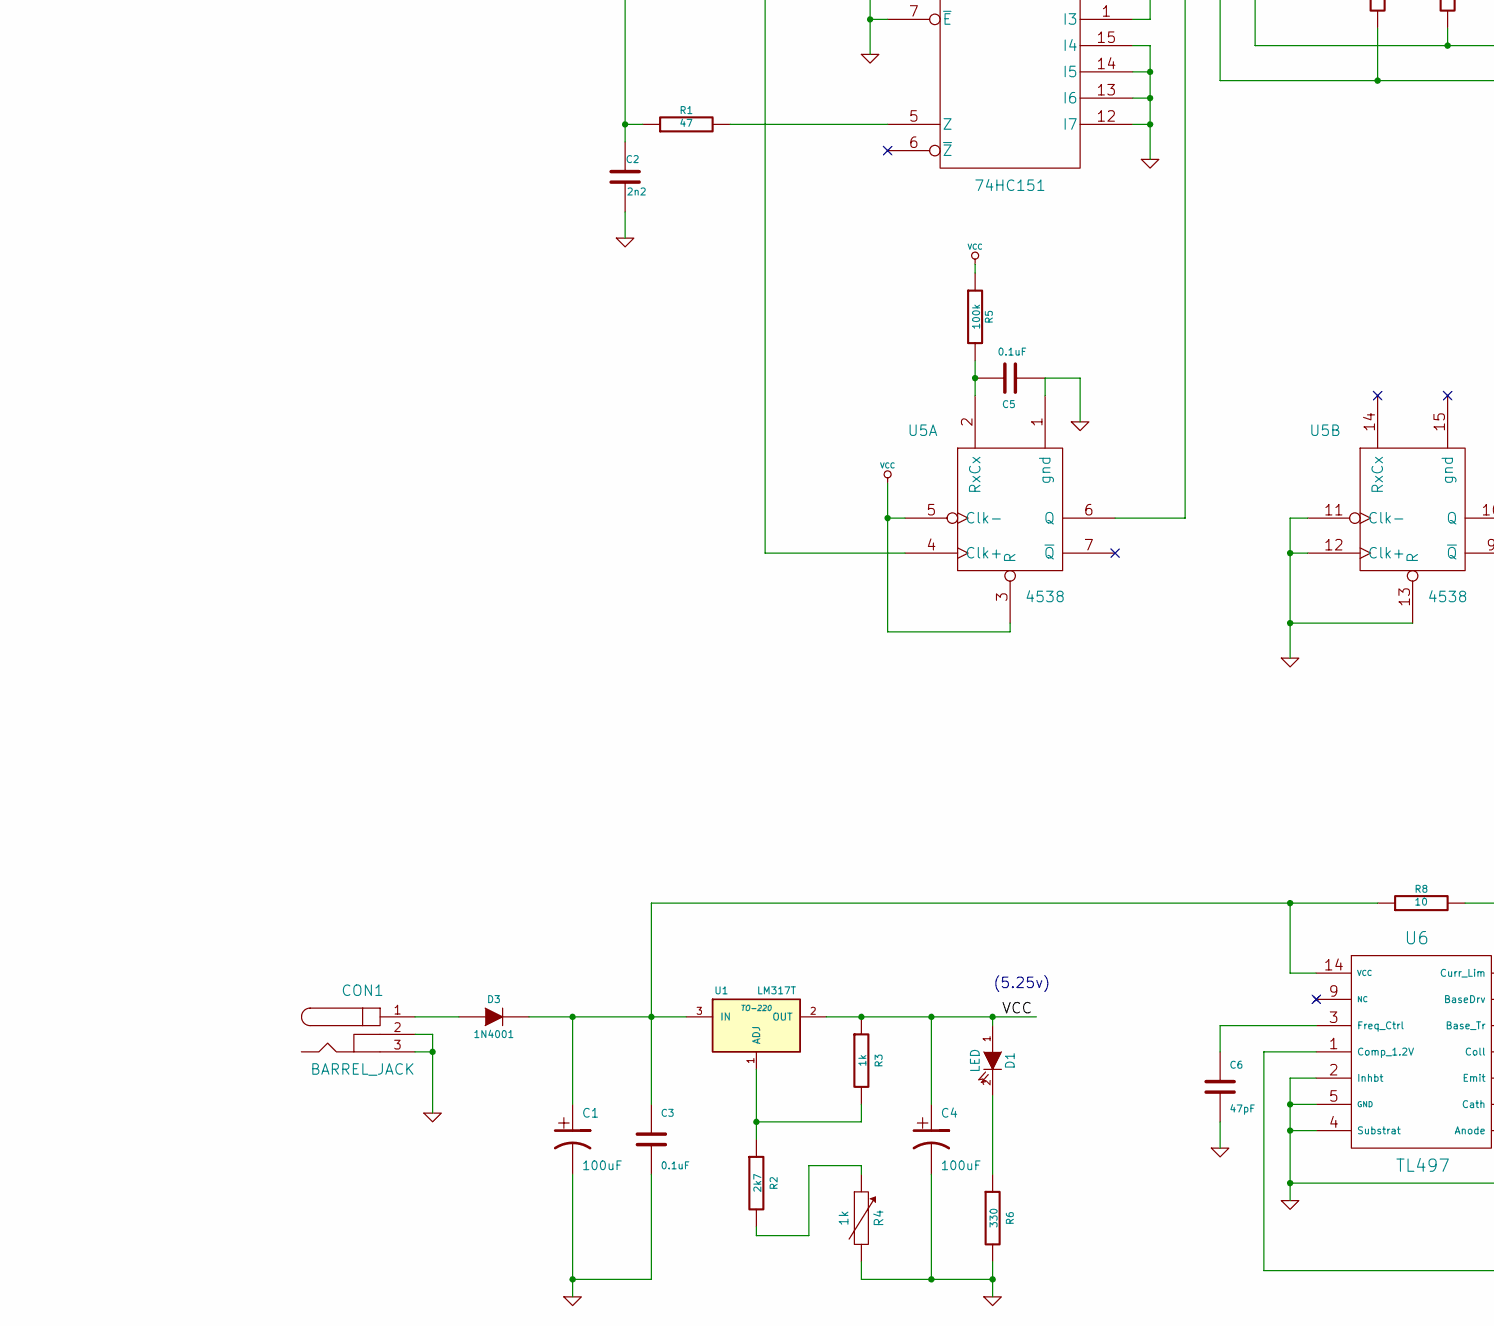
[picture p22: schematic Elm_GAL_Programmer.sch, part in row 2, column 1]

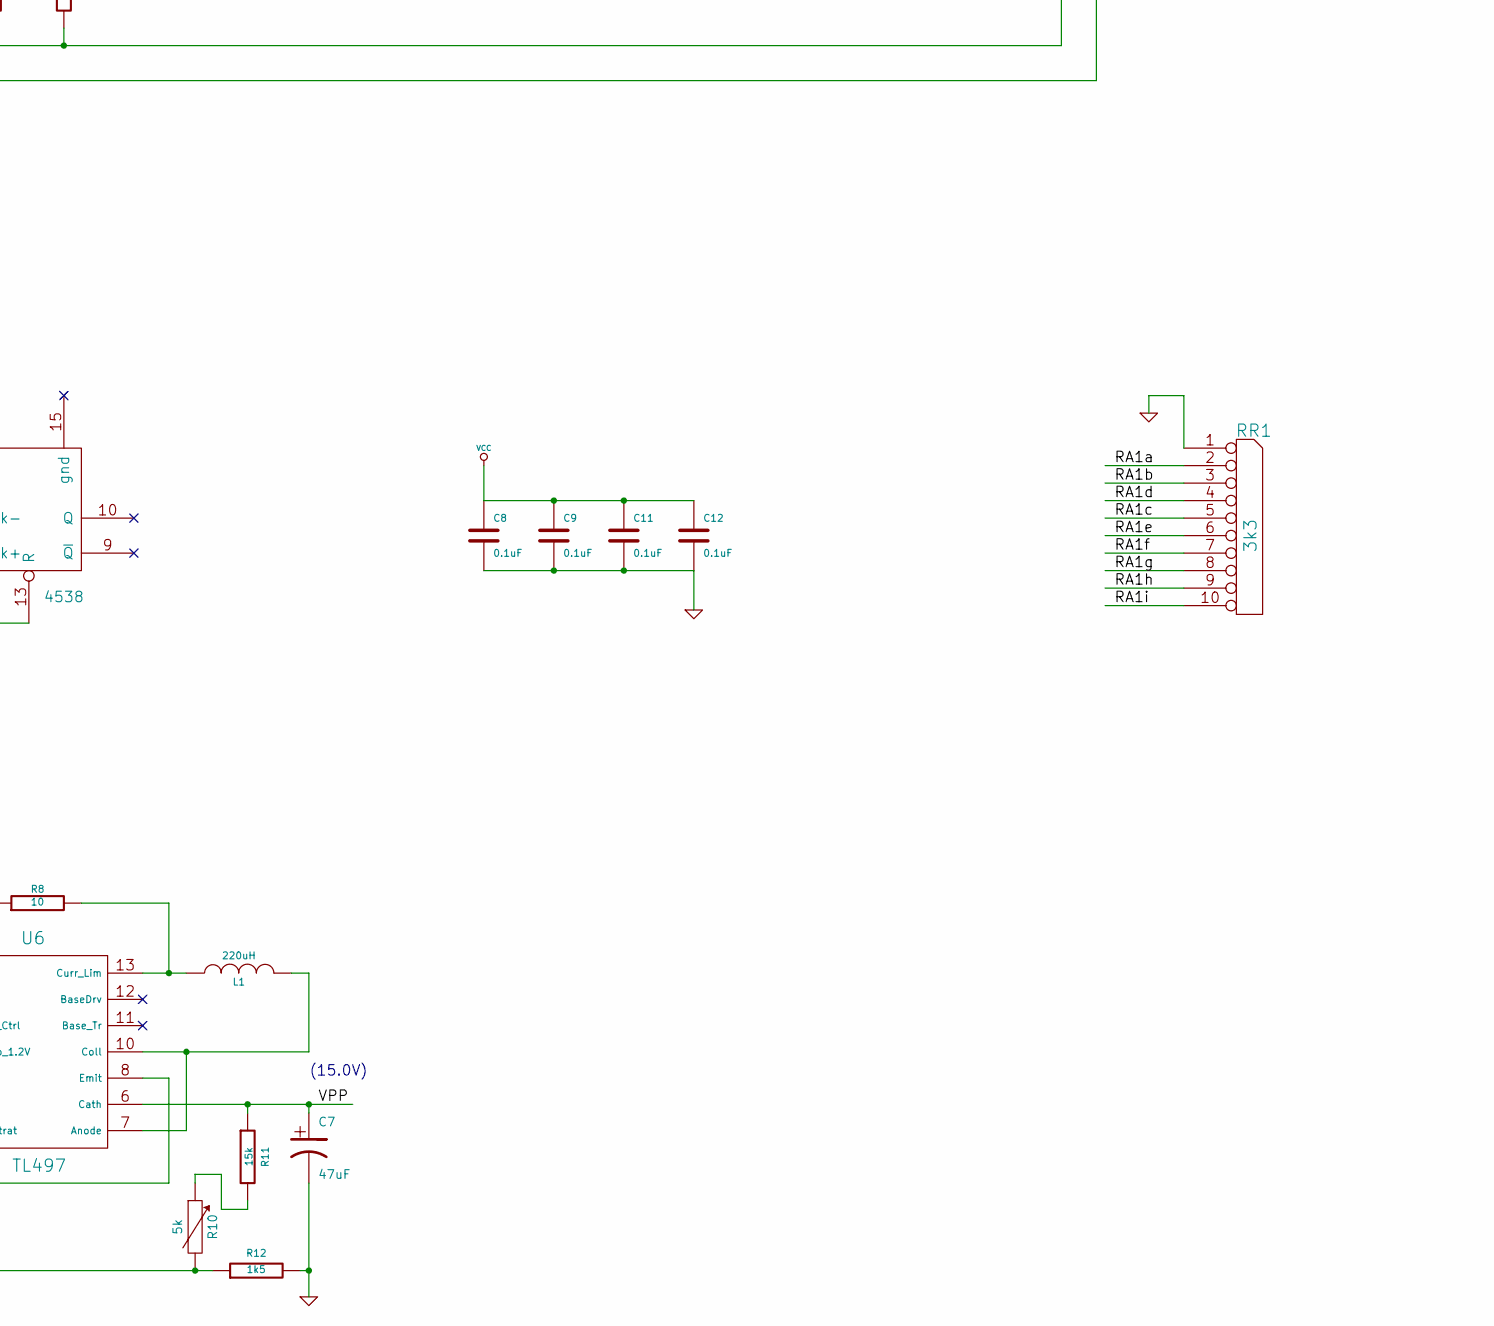
[picture p23: schematic Elm_GAL_Programmer.sch, part in row 2, column 2]

Parts:
C1, C4: 100uF
C2: 2n2
C3, C5, C8, C9, C11, C12: 0.1uF
C6: 47pF
C7: 47uF
CON1: BARREL_JACK
D1: LED
D2: 1N4148
D3: 1N4001
J1: DB25
L1: 220uH
P1: ZIF24
Q1, Q2: DTC114E
Q3, Q4: DTA114E
Q5, Q6: 2SA1020; TO92
R1: 47
R2: 2k7
R3, R4, R13, R14, R15: 1k
R5: 100k
R6: 330
R7, R9: 4k7
R8: 10
R10: 5k
R11: 15k
R12: 1k5
R16, R17: 560
RR1: 3k3
U1: LM317T; TO-220
U2, U3: 74HC595
U4: 74HC151
U5: 4538
U6: TL497

Connections:
/RA1a: P1.1, RR1.2
/RA1b: P1.2, Q4.3 (C), RR1.3
/RA1c: D2.2 (K), P1.4, Q3.3 (C), RR1.5
/RA1d: P1.23, RR1.4
/RA1e: P1.19, RR1.6
/RA1f: P1.18, RR1.7
/RA1g: P1.17, RR1.8
/RA1h: P1.16, RR1.9
GND: C1.2, C2.2, C3.2, C4.2, C5.1, C6.2, C7.2, C8.2, C9.2, C11.2, C12.2, CON1.2, CON1.3, J1.18, J1.19, J1.20, J1.21, J1.22, J1.23, J1.24, J1.25, P1.12, R4.2, R6.2, R12.2, RR1.1 (COM), U2.8 (GND), U2.13 (G), U3.8 (GND), U3.13 (G), U4.7 (~E), U4.8 (GND), U4.9 (S2), U4.12 (I7), U4.13 (I6), U4.14 (I5), U4.15 (I4), U5.1 (gnd), U5.8 (GND), U5.11 (Clk-), U5.12 (Clk+), U5.13 (R), U6.2 (Inhbt), U6.4 (Substrat), U6.5 (GND), U6.8 (Emit)
unnamed: P1.21, R14.2
unnamed: P1.9, U3.1 (QB)
unnamed: P1.20, R13.2
unnamed: P1.22, Q5.2 (C), R15.2
unnamed: R13.1, U2.2 (QC)
unnamed: R14.1, U2.1 (QB)
unnamed: R15.1, U2.15 (QA)
unnamed: P1.6, U2.6 (QG)
unnamed: D2.1 (A), U2.4 (QE)
unnamed: P1.5, U2.5 (QF)
unnamed: Q1.3 (C), Q4.1 (B)
unnamed: P1.7, U2.7 (QH)
unnamed: P1.8, U3.15 (QA)
unnamed: J1.5, U5.4 (Clk+)
unnamed: J1.6, P1.10
unnamed: J1.7, P1.11
unnamed: J1.8, P1.13
unnamed: P1.15, R7.2, U4.3 (I1)
unnamed: R9.1, U3.6 (QG)
unnamed: P1.14, R9.2, U4.4 (I0)
unnamed: U4.2 (I2), U5.6 (Q)
unnamed: P1.3, U2.3 (QD)
unnamed: Q2.2 (E), U3.4 (QE)
unnamed: Q1.2 (E), U3.5 (QF)
unnamed: R7.1, U3.7 (QH)
unnamed: C2.1, J1.11, R1.1
unnamed: CON1.1, D3.1 (A)
unnamed: R16.2, U3.2 (QC)
unnamed: Q6.3 (B), R17.1
unnamed: R17.2, U3.3 (QD)
unnamed: Q5.3 (B), R16.1
unnamed: P1.24, Q6.2 (C)
unnamed: L1.2, U6.7 (Anode), U6.10 (Coll)
unnamed: R10.2, R12.1, U6.1 (Comp_1.2V)
unnamed: L1.1, R8.2, U6.13 (Curr_Lim)
unnamed: C5.2, R5.2, U5.2 (RxCx)
unnamed: R10.1, R11.2
unnamed: C6.1, U6.3 (Freq_Ctrl)
unnamed: R2.1, R3.2, U1.1 (ADJ)
unnamed: R2.2, R4.1
unnamed: D1.2 (K), R6.1
unnamed: C1.1, C3.1, D3.2 (K), R8.1, U1.3 (IN), U6.14 (VCC)
unnamed: U2.9 (~QH), U3.14 (SER)
unnamed: J1.3, U2.11 (SRCLK), U3.11 (SRCLK), U4.10 (S1)
unnamed: R1.2, U4.5 (Z)
unnamed: J1.4, U2.12 (RCLK), U3.12 (RCLK)
unnamed: U3.9 (~QH), U4.1 (I3)
unnamed: Q2.3 (C), Q3.1 (B)
unnamed: J1.2, U2.14 (SER), U4.11 (S0)
VCC: C4.1, C8.1, C9.1, C11.1, C12.1, D1.1 (A), Q1.1 (B), Q2.1 (B), Q5.1 (E), Q6.1 (E), R3.1, R5.1, U1.2 (OUT), U2.10 (SRCLR), U2.16 (VCC), U3.10 (SRCLR), U3.16 (VCC), U4.16 (VCC), U5.3 (R), U5.5 (Clk-), U5.16 (VCC)
VPP: C7.1, Q3.2 (E), Q4.2 (E), R11.1, U6.6 (Cath)

Notes on the sheet:
(5.25v)
(15.0V)

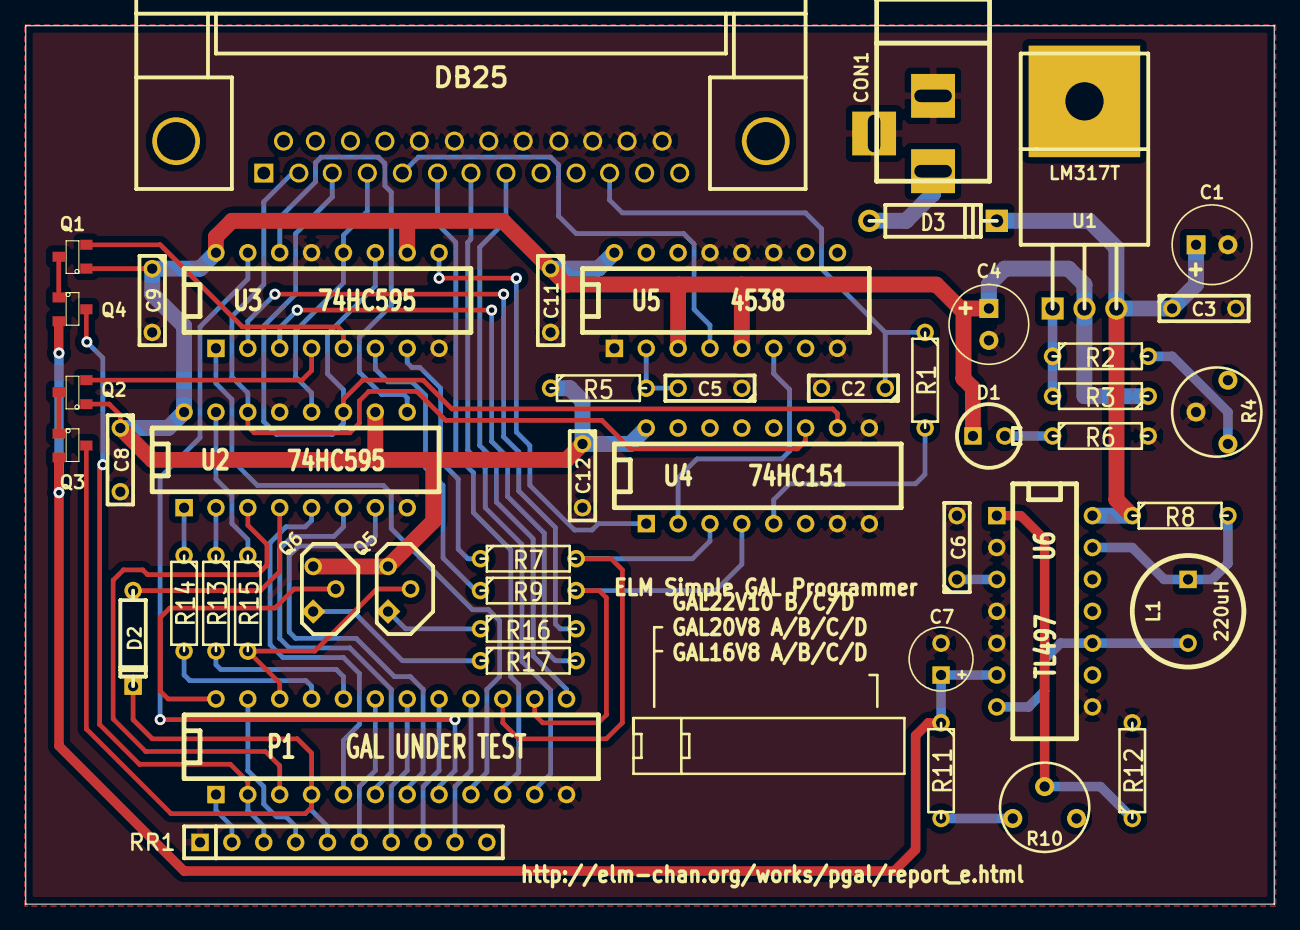
[picture p24: board Elm_GAL_Programmer.kicad_pcb from above]

Board: 2 copper layers, 99.5 x 70.0 mm, 48 parts (0 on the bottom side), 60 nets.
