NaoPross/z80uPC/sw/z80/kernel/include/devices.h

#ifndef __DEVICES_H__
#define __DEVICES_H__

#define ADDR_DEV_ROM_L      0x0000
#define ADDR_DEV_ROM_H      0x2000

#define ADDR_DEV_USART      0x4000
#define ADDR_DEV_CTC        0x4100
#define ADDR_DEV_PIO        0x4200

#define ADDR_DEV_RAM        0x8000

#endif
