NaoPross/z80uPC/sw/z80/kernel/include/types.h

#ifndef __TYPES_H__
#define __TYPES_H__

#define register_t  volatile unsigned char

#define int8_t      char
#define uint8_t     unsigned char
#define int16_t     int
#define uint16_t    unsigned int

#define size_t      uint16_t

#endif
