NaoPross/z80uPC/(commit log)

2017-02-14 first commit, downloaded doc
    [BOM.ods]
2017-02-14 hw: created z80acpu in sch library
    [z80uPC.PrjPCB, zilog_z80.SchLib]
2017-02-24 hw: created sch, doc: added uart datasheet
    [MainSheet.SchDoc, z80uPC.PrjPCB]
2017-02-24 hw: created library project, doc: added 74LS193 datasheet
    [HITACHI Memory Non-Volatile RAM.SchLib, z80uPC.PrjPCB, z80uPC.SCHLIB, zilog_z80.SchLib]
2017-03-05 doc: added L7805ACV datasheet; hw: updated scheme
    [HITACHI Memory Non-Volatile RAM.SchLib, MainSheet.SchDoc, z80uPC.PrjPCB, z80uPC.SCHLIB]
2017-03-06 hw: moved everything to one sheet
    [IODevices.SchDoc, MainSheet.SchDoc, Seiko Epson Oscillator.SchLib, z80uPC.PrjPCB, z80uPC.SCHLIB]
2017-03-07 updated todolist; doc: keyboard stuff
    [pc104conn.csv]
2017-03-17 hardware nearly finished
    doc: added datasheets for
    - GAL16V8
    - MAX214
    - MAX232
    added script to build doc under windows with miktex
    updated notes
    hw: finished i/o devices and bus viewer
    sw: created files for pld programming
    [BusViewer.SchDoc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]
2017-03-23 changed scheme layout
    hw: changed scheme and annotated components
    doc: added build script for windows
    sw: added res/ folder with blaster and created jedec document for
    address decoder pld
    [ATFblast.pcb, BusViewer.SchDoc, IODevices.SchDoc, MainSheet.SchDoc, Power.SchDoc, pc104conn.csv, z80uPC.PrjPCB]
2017-03-31 added iospace address decoder
    [BusViewer.SchDoc, MainSheet.SchDoc, Power.SchDoc]
2017-04-04 schematic complete
    hw: change address decoder chip from GAL16V8 to M4-32/32 (CPLD)
    change main bus connector with a custom one (intead of PC/104)
    start building footprint library
    [BusViewer.SchDoc, IODevices.SchDoc, MainSheet.SchDoc, Peripherals.SchDoc, Power.SchDoc, z80uPC.PcbLib, z80uPC.PrjPCB, z80uPC.SCHLIB]
2017-04-13 switch from GAL (pld) to M4 32/32 CPLD
    add M4 32/32 CPLD datasheet
    new VHDL code with better control over the address space thanks to the
    M4 which has a 16 bit input port
2017-04-13 scheme update and PCB start
    add missing capacitor and resistor values (serial XTAL)
    create new eurocard standard compliant PCB for the uPC
    and other minor fixes
    [BusViewer.SchDoc, IODevices.SchDoc, MainBoard.PcbDoc, MainSheet.SchDoc, Peripherals.SchDoc, z80uPC.PcbLib, z80uPC.PrjPCB]
2017-04-28 start printed circuit board design
    wired:
    - clock circiuts
    - reset button
    set layout for:
    - CPU & memory
    - serial interface
    [BusViewer.SchDoc, IODevices.SchDoc, MainBoard.PcbDoc, MainSheet.SchDoc, Peripherals.SchDoc, z80uPC.PcbLib, z80uPC.PrjPCB, z80uPC.SCHLIB]
2017-05-01 switch to sdcc
    - update of the makefile to use sdcc, since it is more popular and
    it's easier to insall on other computers
    - fix of crt0.s (old loader.asm) for the new compiler
    - change of the structure in the source code folder to separate
    betweeen libc and kernel code
    [types.h]
2017-05-02 fix for sdcc makefile
    fix for the old makefile, because it could't compile more than one source file.
    new libc directory with mem.c to start implementing the standard C library
    (or at least the part we need).
    [types.h]
2017-05-02 add serial device struct
    other changes:
    - change from main() to kmain() in crt0.s and kernel.c
    - new file devices.h to define all address locations for devices
    - new data type
    - register_t as volatile uint8_t for registers in devices
    - size_t from libc
2017-05-05 add switches datasheets for footprints
    [MainBoard.PcbDoc, MainSheet.SchDoc, z80uPC.PrjPCB]
2017-05-05 complete wiring for serial interface connector and logic
    - new layout, probably the board will have to be resized to a
    nonstandard size (currently 2EUROCARD)
    - new footprint HDR5x2_SOCKET for standard 5x2 flatcable connectors
    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
    [IODevices.SchDoc, MainBoard.PcbDoc, MainSheet.SchDoc, Peripherals.SchDoc, z80uPC.PcbLib, z80uPC.SCHLIB]
2017-05-09 created new layout (starting over)
    the old layout is still under hw/MainBoard1.PcbDoc
    [MainBoard.PcbDoc, MainBoard1.PcbDoc, MainSheet.SchDoc, z80uPC.PrjPCB]
2017-05-18 wires from DB-9 and HDR5x2 connector to MAX214 (U7) and crystal for TL16C550
    [MainBoard.PcbDoc]
2017-05-18 wiring for P4 and P5 (I/O ports) and circuits for CLKs and RST
    [MainBoard.PcbDoc]
2017-05-18 wiring for CTC (U8) to address bus and data bus
    [MainBoard.PcbDoc]
2017-05-18 new traces for cpu signals and for high address to the MMU / addr decoder
    there are also many other minor changes to connect various wires
    [MainBoard.PcbDoc]
2017-05-19 wiring for 7 segment displays and traces for the remaining CPU signals
    [MainBoard.PcbDoc]
2017-05-19 finish wiring and add eurocard compliant standard holes
    since there wasn't enough space (I should have added the holes before
    beginning) there are only 4 holes instead of 6 (2 will be cut out
    since the space is unused).
    [MainBoard.PcbDoc, MainBoard.PcbLib, Peripherals.SchDoc]
2017-05-23 board complete, generate gerber (x2) files
    this is probably the last commit before printing the PCB, unless there are some
    other errors in the board design
    [MainBoard.PcbDoc, MainBoard.PcbLib, MainBoard1.PcbDoc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]
2017-06-02 add serial interface and a few std library functions
    changes in usart:
    - new functions to setup the serial comunication settings such as baudrate,
    parity and stop bits
    - init function with most common values
    - transmit and receive functions each with a wrapper to send data blocks
    changes in libc:
    - new file stdio.c with basic implementation of putch, printf still a prototype
    - new file string.c with memcpy() function
2017-06-10 add port interface header, api still to implement
    fix for bug in usart.c, in function usart_write() that checked the
    trasmission_empty register at the wrong time causing it to overwrite
    the buffer.
    [pio.c, pio.h, usart.c]
2017-06-16 fixed typo in usart.h and in doc
    [usart.h]
